shivamchudasama/KumikoFrame_3DPrinting/Print Profiles & STLs/README.md

The Files may NOT be shared, sold, or redistributed in any way. That includes STL Files, OpenScad (.scad) files, 3MF files, Links, or any file downloaded from this membership. 

Patreon Catalogue: https://docs.google.com/document/d/19o8Xd_KaTCOf8iYQQnmPdljipetqtiDV3wMY0SX3PGU/edit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

Source Code Instructions: https://docs.google.com/document/d/19o8Xd_KaTCOf8iYQQnmPdljipetqtiDV3wMY0SX3PGU/edit?tab=t.pa5v3ukzsqc0

Assembly Instructions: https://docs.google.com/document/d/19o8Xd_KaTCOf8iYQQnmPdljipetqtiDV3wMY0SX3PGU/edit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

License Details: https://docs.google.com/document/d/1-UtIYotxhSvtmS18F5mEnJnP0xTTbvH1-aNAVjrADTA/edit?usp=sharing
