shivamchudasama/KumikoFrame_3DPrinting/Shivling/Referance Layout.png

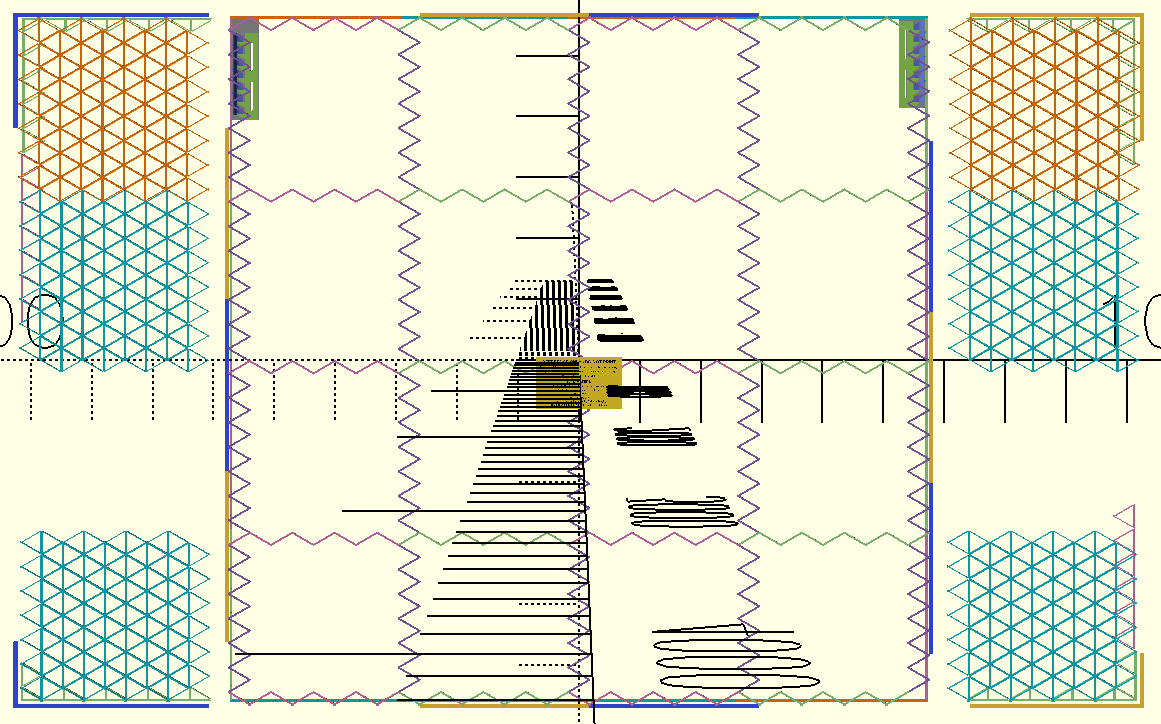
Shivling/Referance Layout.png
