shivamchudasama/KumikoFrame_3DPrinting/Shivling/Shivling_ModernArt_Shivam2_1_2.png

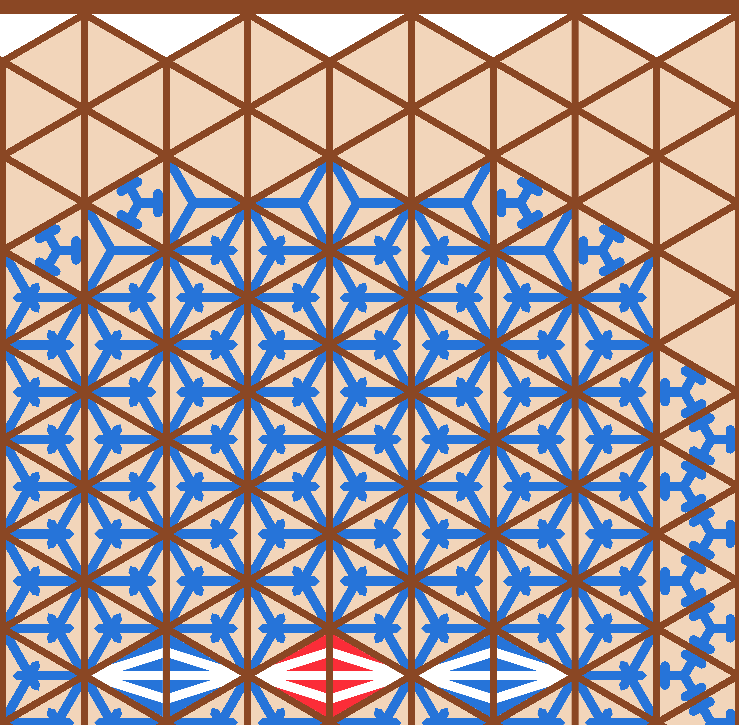
Shivling/Shivling_ModernArt_Shivam2_1_2.png
