shivamchudasama/KumikoFrame_3DPrinting/Shivling/Shivling_ModernArt_Shivam2_1_4.png

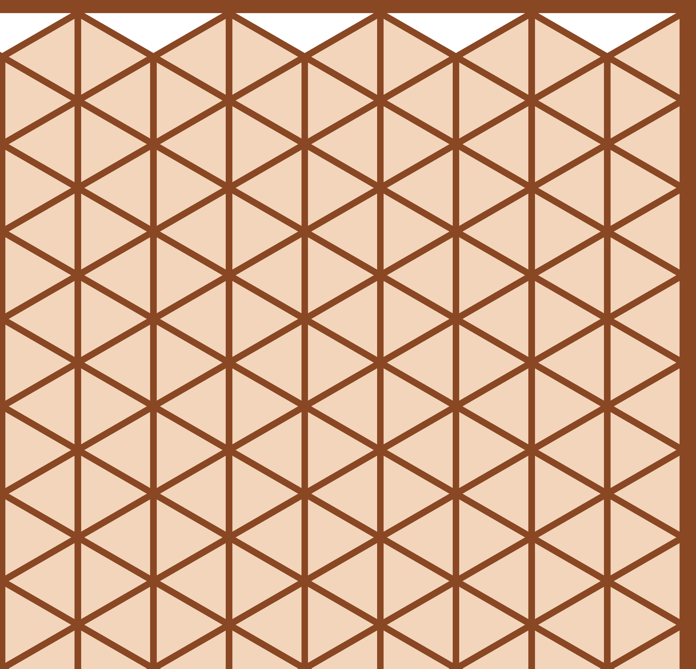
Shivling/Shivling_ModernArt_Shivam2_1_4.png
