shivamchudasama/KumikoFrame_3DPrinting/Shivling/Shivling_ModernArt_Shivam2_2_1.png

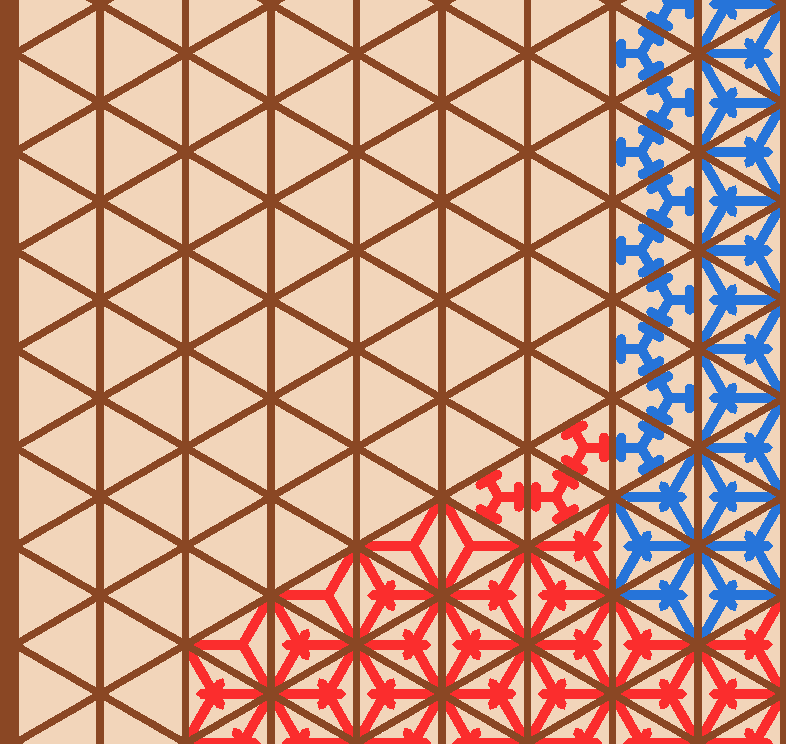
Shivling/Shivling_ModernArt_Shivam2_2_1.png
