shivamchudasama/KumikoFrame_3DPrinting/Shivling/Shivling_ModernArt_Shivam2_2_4.png

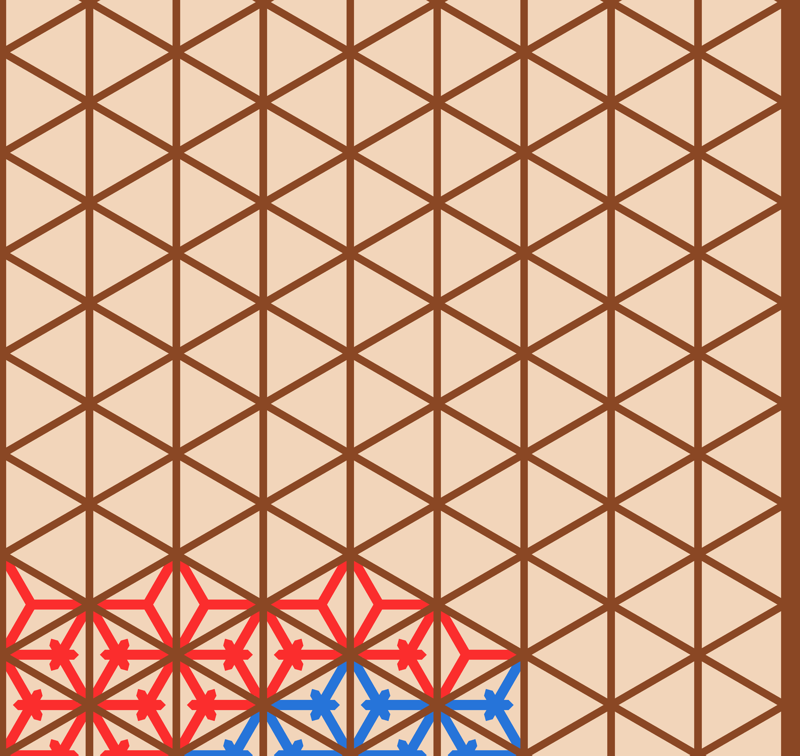
Shivling/Shivling_ModernArt_Shivam2_2_4.png
