shivamchudasama/KumikoFrame_3DPrinting/Shivling/Shivling_ModernArt_Shivam2_3_1.png

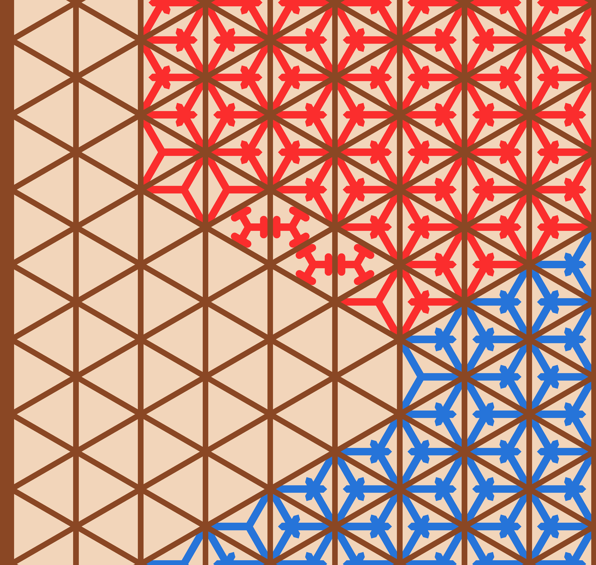
Shivling/Shivling_ModernArt_Shivam2_3_1.png
