shivamchudasama/KumikoFrame_3DPrinting/Shivling/Shivling_ModernArt_Shivam2_4_1.png

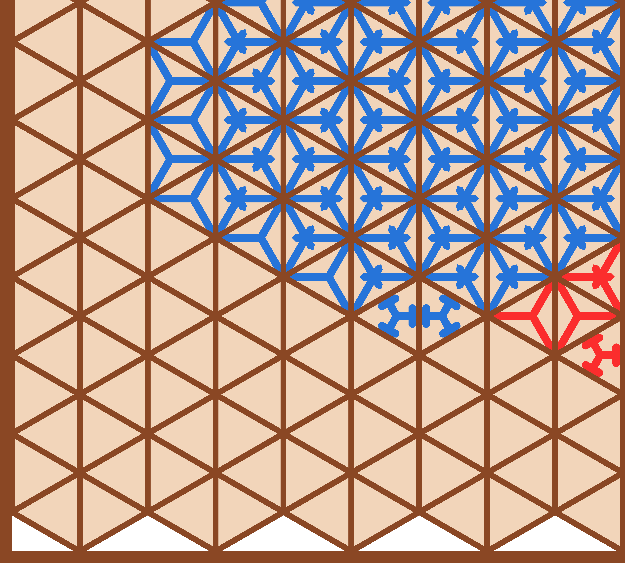
Shivling/Shivling_ModernArt_Shivam2_4_1.png
