shivamchudasama/KumikoFrame_3DPrinting/Print Profiles & STLs/V1 - Primary Panel/Frame Components.3mf

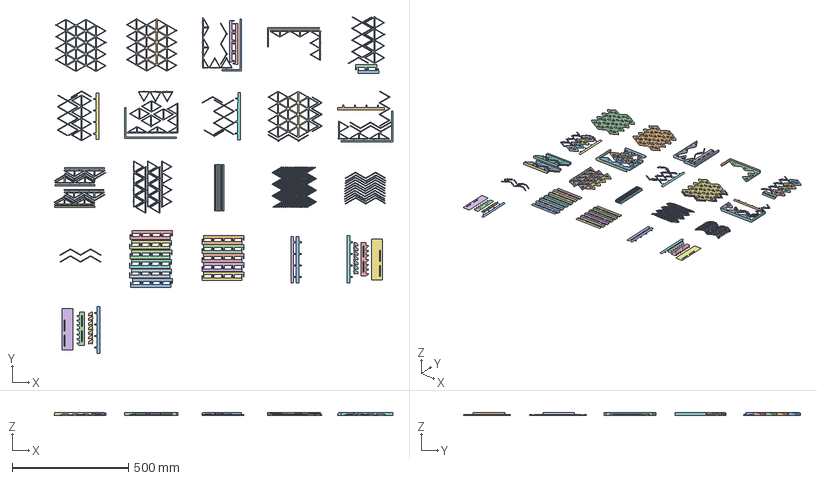
[picture p150: CAD file, 2026-07-01]
Print Profiles & STLs/V1 - Primary Panel/Frame Components.3mf
1458.2 x 1449.7 x 12.0 mm
Assembly x 11
even_hanger.stl_4
even_hanger.stl_5
even_hanger.stl_6
even_hanger.stl_7
