shivamchudasama/KumikoFrame_3DPrinting/Print Profiles & STLs/V1 - Secondary Panels/Frame Components.3mf

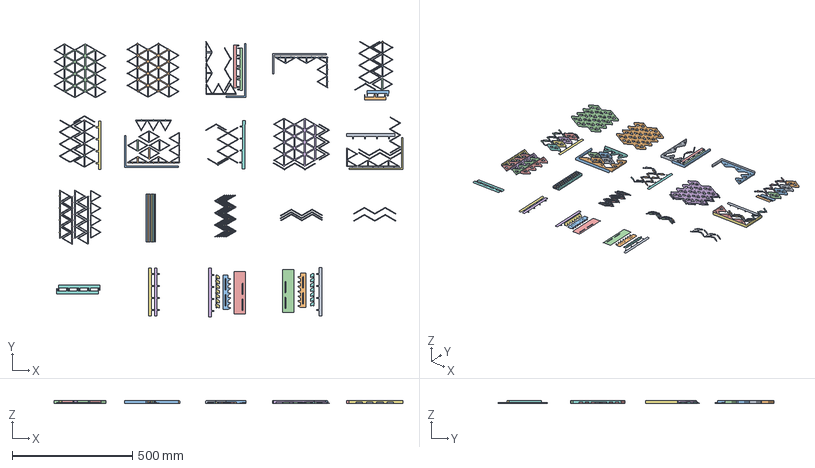
[picture p151: CAD file, 2026-07-01]
Print Profiles & STLs/V1 - Secondary Panels/Frame Components.3mf
1451.8 x 1147.7 x 12.0 mm
Assembly
even_hanger.stl_4
even_hanger.stl_5
even_hanger.stl_6
even_hanger.stl_7
