shivamchudasama/KumikoFrame_3DPrinting/Print Profiles & STLs/V2 - Fjallbo Compatible/Frame Components.3mf

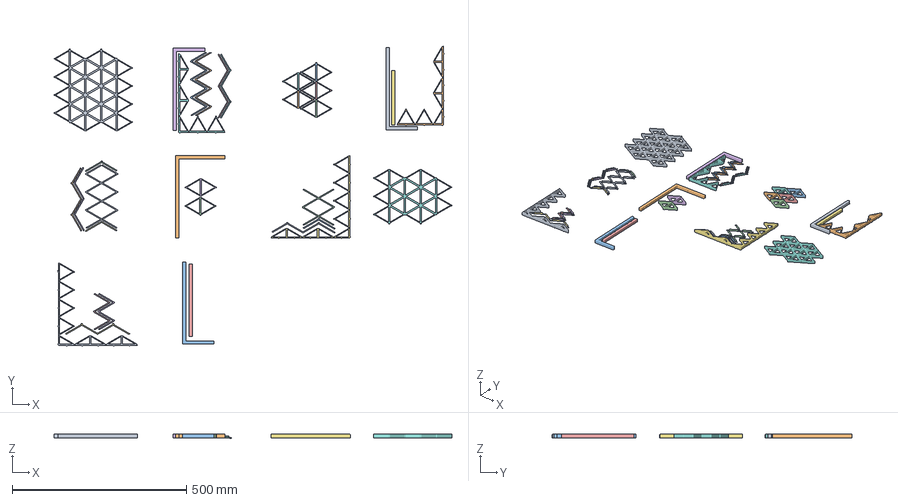
[picture p152: CAD file, 2026-07-01]
Print Profiles & STLs/V2 - Fjallbo Compatible/Frame Components.3mf
1142.2 x 860.6 x 12.0 mm
Frame Components.stl_2
Frame Components.stl_3
Frame Components.stl_13
Frame Components.stl_17
Frame Components.stl_10
Frame Components.stl_18
Frame Components.stl_4
Frame Components.stl_11
Frame Components.stl_5
Frame Components.stl_12
Frame Components.stl_6
Frame Components.stl_19
Frame Components.stl_8
Frame Components.stl_9
Frame Components.stl_15
Frame Components.stl_16
Frame Components.stl_20
Frame Components.stl_21
Frame Components.stl_22
Frame Components.stl_23
Frame Components.stl_24
Frame Components.stl_25
Frame Components.stl_26
Frame Components.stl_27
Frame Components.stl_28
Frame Components.stl_29
Frame Components.stl_30
Frame Components.stl_31
Frame Components.stl_32
Frame Components.stl_33
Frame Components.stl_34
Frame Components.stl_35
Frame Components.stl_36
Frame Components.stl_37
