shivamchudasama/KumikoFrame_3DPrinting/Print Profiles & STLs/V2 - Primary Panel & Alternatives/STLs/Magnet Holder.stl

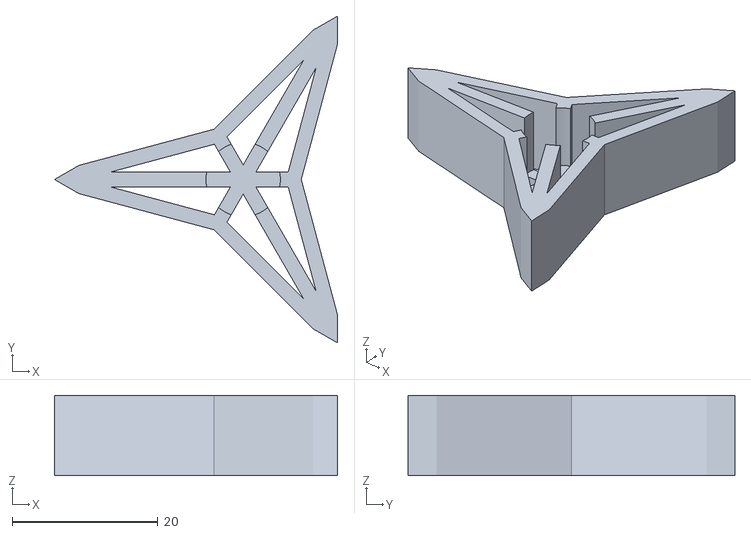
[picture p154: CAD file, 2026-07-01]
Print Profiles & STLs/V2 - Primary Panel & Alternatives/STLs/Magnet Holder.stl
38.8 x 44.8 x 11.0
