shivamchudasama/KumikoFrame_3DPrinting/Print Profiles & STLs/V2 - Primary Panel & Alternatives/Test Tube & Magnet Holder.3mf

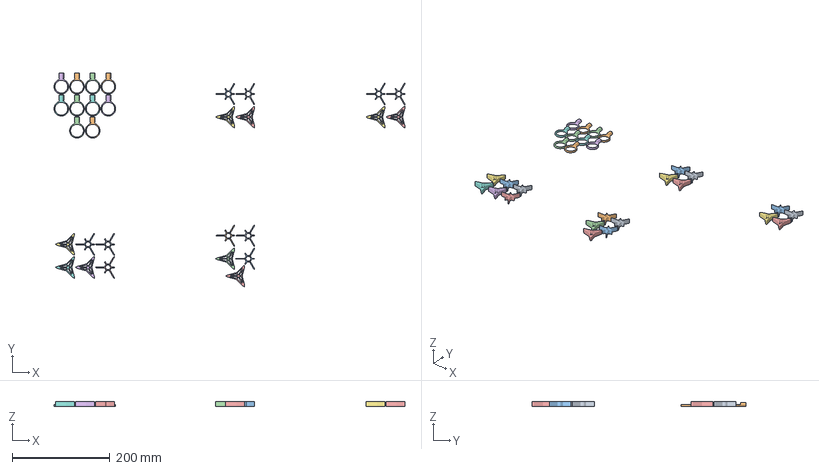
[picture p155: CAD file, 2026-07-01]
Print Profiles & STLs/V2 - Primary Panel & Alternatives/Test Tube & Magnet Holder.3mf
717.2 x 437.3 x 11.0 mm
Test Tube Holder.stl_1 x 10
Test Tube Holder.stl_2 x 10
Magnet Holder.stl x 9
