shivamchudasama/KumikoFrame_3DPrinting/Shivling/Boarder.3mf

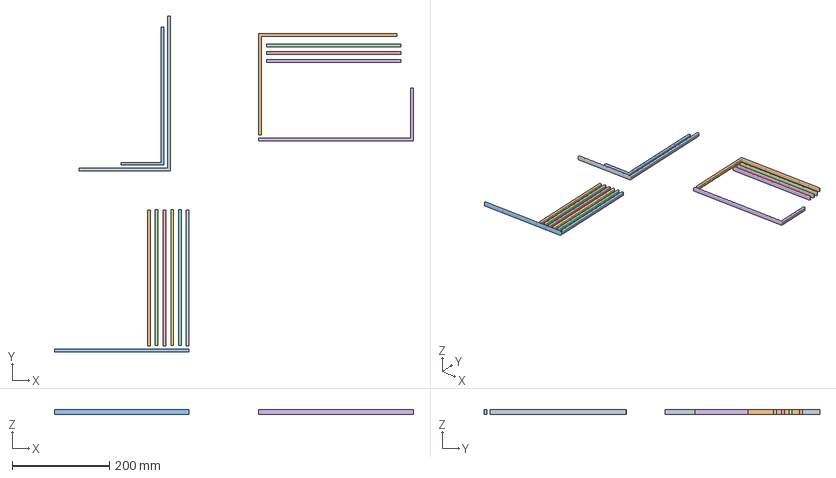
[picture p156: CAD file, 2026-07-20]
Shivling/Boarder.3mf
739.1 x 691.6 x 10.0 mm
Boarder.stl_1
Boarder.stl_11
Boarder.stl_6
Boarder.stl_2
Boarder.stl_4
Boarder.stl_5
Boarder.stl_12
Boarder.stl_14
Boarder.stl_3
Boarder.stl_13
Boarder.stl_7
Boarder.stl_8
Boarder.stl_9
Boarder.stl_10
