shivamchudasama/KumikoFrame_3DPrinting/Print Profiles & STLs/V1 - Primary Panel/Pattern Inserts.3mf

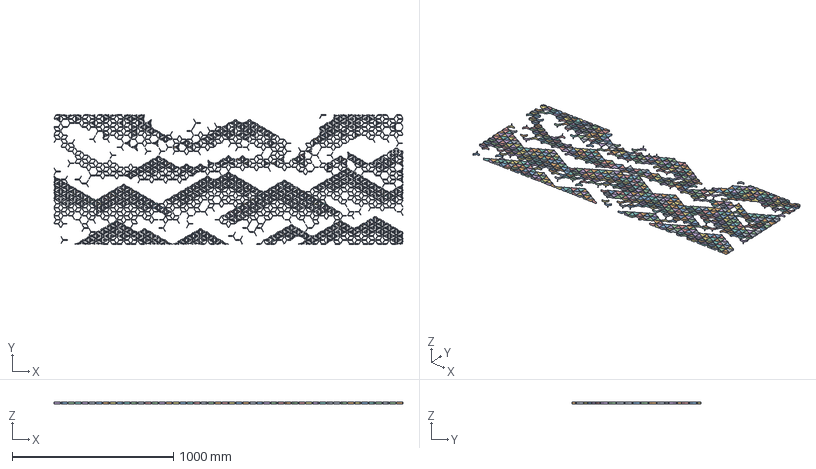
[picture p157: CAD file, 2026-07-01]
Print Profiles & STLs/V1 - Primary Panel/Pattern Inserts.3mf
2162.1 x 800.0 x 11.0 mm
Pattern Inserts.stl_283
Pattern Inserts.stl_284
Pattern Inserts.stl_299
Pattern Inserts.stl_300
Pattern Inserts.stl_311
Pattern Inserts.stl_312
Pattern Inserts.stl_313
Pattern Inserts.stl_324
Pattern Inserts.stl_333
Pattern Inserts.stl_334
Pattern Inserts.stl_352
Pattern Inserts.stl_353
Pattern Inserts.stl_354
Pattern Inserts.stl_373
Pattern Inserts.stl_374
Pattern Inserts.stl_375
Pattern Inserts.stl_393
Pattern Inserts.stl_409
Pattern Inserts.stl_422
Pattern Inserts.stl_435
Pattern Inserts.stl_445
Pattern Inserts.stl_446
Pattern Inserts.stl_458
Pattern Inserts.stl_459
Pattern Inserts.stl_460
Pattern Inserts.stl_467
Pattern Inserts.stl_468
Pattern Inserts.stl_469
Pattern Inserts.stl_476
Pattern Inserts.stl_481
Pattern Inserts.stl_482
Pattern Inserts.stl_491
Pattern Inserts.stl_492
Pattern Inserts.stl_493
Pattern Inserts.stl_503
Pattern Inserts.stl_504
Pattern Inserts.stl_505
Pattern Inserts.stl_523
Pattern Inserts.stl_524
Pattern Inserts.stl_525
Pattern Inserts.stl_539
Pattern Inserts.stl_548
Pattern Inserts.stl_549
Pattern Inserts.stl_565
Pattern Inserts.stl_566
Pattern Inserts.stl_567
Pattern Inserts.stl_589
Pattern Inserts.stl_590
Pattern Inserts.stl_591
Pattern Inserts.stl_610
Pattern Inserts.stl_611
Pattern Inserts.stl_612
Pattern Inserts.stl_638
Pattern Inserts.stl_639
Pattern Inserts.stl_1
Pattern Inserts.stl_2
Pattern Inserts.stl_3
Pattern Inserts.stl_4
Pattern Inserts.stl_5
Pattern Inserts.stl_6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
