shivamchudasama/KumikoFrame_3DPrinting/Print Profiles & STLs/V1 - Secondary Panels/Pattern Inserts - Symmetry.3mf

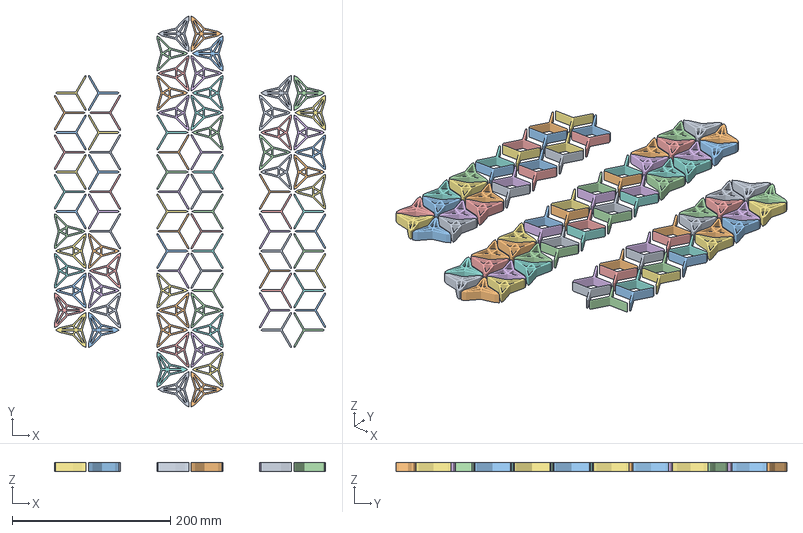
[picture p158: CAD file, 2026-07-01]
Print Profiles & STLs/V1 - Secondary Panels/Pattern Inserts - Symmetry.3mf
343.4 x 494.8 x 11.0 mm
Pattern Inserts - Symmetry.stl_1
Pattern Inserts - Symmetry.stl_2
Pattern Inserts - Symmetry.stl_3
Pattern Inserts - Symmetry.stl_4
Pattern Inserts - Symmetry.stl_5
Pattern Inserts - Symmetry.stl_6
Pattern Inserts - Symmetry.stl_7
Pattern Inserts - Symmetry.stl_8
Pattern Inserts - Symmetry.stl_9
Pattern Inserts - Symmetry.stl_10
Pattern Inserts - Symmetry.stl_11
Pattern Inserts - Symmetry.stl_12
Pattern Inserts - Symmetry.stl_13
Pattern Inserts - Symmetry.stl_14
Pattern Inserts - Symmetry.stl_15
Pattern Inserts - Symmetry.stl_16
Pattern Inserts - Symmetry.stl_17
Pattern Inserts - Symmetry.stl_18
Pattern Inserts - Symmetry.stl_19
Pattern Inserts - Symmetry.stl_20
Pattern Inserts - Symmetry.stl_21
Pattern Inserts - Symmetry.stl_22
Pattern Inserts - Symmetry.stl_23
Pattern Inserts - Symmetry.stl_24
Pattern Inserts - Symmetry.stl_25
Pattern Inserts - Symmetry.stl_26
Pattern Inserts - Symmetry.stl_27
Pattern Inserts - Symmetry.stl_28
Pattern Inserts - Symmetry.stl_29
Pattern Inserts - Symmetry.stl_30
Pattern Inserts - Symmetry.stl_31
Pattern Inserts - Symmetry.stl_32
Pattern Inserts - Symmetry.stl_33
Pattern Inserts - Symmetry.stl_34
Pattern Inserts - Symmetry.stl_35
Pattern Inserts - Symmetry.stl_36
Pattern Inserts - Symmetry.stl_37
Pattern Inserts - Symmetry.stl_38
Pattern Inserts - Symmetry.stl_39
Pattern Inserts - Symmetry.stl_40
Pattern Inserts - Symmetry.stl_41
Pattern Inserts - Symmetry.stl_42
Pattern Inserts - Symmetry.stl_43
Pattern Inserts - Symmetry.stl_44
Pattern Inserts - Symmetry.stl_45
Pattern Inserts - Symmetry.stl_46
Pattern Inserts - Symmetry.stl_47
Pattern Inserts - Symmetry.stl_48
Pattern Inserts - Symmetry.stl_49
Pattern Inserts - Symmetry.stl_50
Pattern Inserts - Symmetry.stl_51
Pattern Inserts - Symmetry.stl_52
Pattern Inserts - Symmetry.stl_53
Pattern Inserts - Symmetry.stl_54
Pattern Inserts - Symmetry.stl_55
Pattern Inserts - Symmetry.stl_56
Pattern Inserts - Symmetry.stl_57
Pattern Inserts - Symmetry.stl_58
Pattern Inserts - Symmetry.stl_59
Pattern Inserts - Symmetry.stl_60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
