shivamchudasama/KumikoFrame_3DPrinting/Print Profiles & STLs/V2 - Fjallbo Compatible/Pattern Inserts.3mf

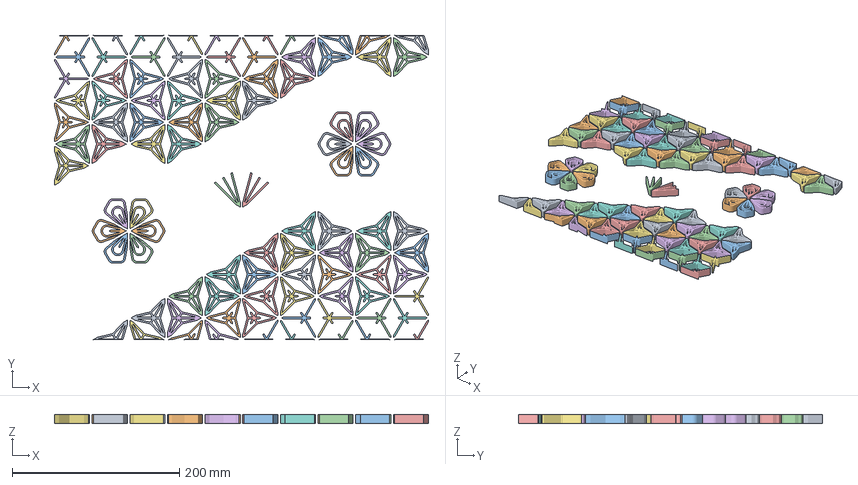
[picture p159: CAD file, 2026-07-01]
Print Profiles & STLs/V2 - Fjallbo Compatible/Pattern Inserts.3mf
447.3 x 364.0 x 11.0 mm
Pattern Inserts.stl_22
Pattern Inserts.stl_23
Pattern Inserts.stl_24
Pattern Inserts.stl_25
Pattern Inserts.stl_27
Pattern Inserts.stl_29
Pattern Inserts.stl_30
Pattern Inserts.stl_32
Pattern Inserts.stl_33
Pattern Inserts.stl_35
Pattern Inserts.stl_37
Pattern Inserts.stl_38
Pattern Inserts.stl_39
Pattern Inserts.stl_41
Pattern Inserts.stl_43
Pattern Inserts.stl_45
Pattern Inserts.stl_46
Pattern Inserts.stl_48
Pattern Inserts.stl_49
Pattern Inserts.stl_51
Pattern Inserts.stl_52
Pattern Inserts.stl_53
Pattern Inserts.stl_54
Pattern Inserts.stl_55
Pattern Inserts.stl_57
Pattern Inserts.stl_60
Pattern Inserts.stl_61
Pattern Inserts.stl_62
Pattern Inserts.stl_63
Pattern Inserts.stl_64
Pattern Inserts.stl_66
Pattern Inserts.stl_68
Pattern Inserts.stl_69
Pattern Inserts.stl_71
Pattern Inserts.stl_73
Pattern Inserts.stl_74
Pattern Inserts.stl_75
Pattern Inserts.stl_76
Pattern Inserts.stl_78
Pattern Inserts.stl_80
Pattern Inserts.stl_1
Pattern Inserts.stl_2
Pattern Inserts.stl_3
Pattern Inserts.stl_4
Pattern Inserts.stl_5
Pattern Inserts.stl_6
Pattern Inserts.stl_7
Pattern Inserts.stl_8
Pattern Inserts.stl_9
Pattern Inserts.stl_10
Pattern Inserts.stl_11
Pattern Inserts.stl_12
Pattern Inserts.stl_13
Pattern Inserts.stl_14
Pattern Inserts.stl_15
Pattern Inserts.stl_16
Pattern Inserts.stl_17
Pattern Inserts.stl_18
Pattern Inserts.stl_19
Pattern Inserts.stl_20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
