shivamchudasama/KumikoFrame_3DPrinting/Print Profiles & STLs/V2 - Gorilla Shelf Compatible/Keyhole Hanger.3mf

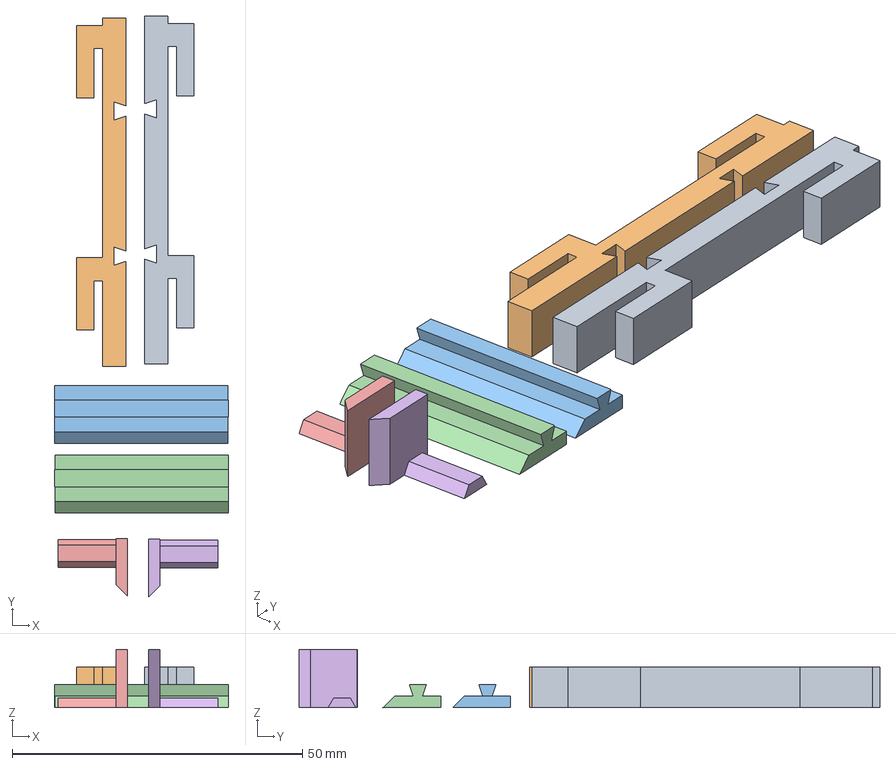
[picture p160: CAD file, 2026-07-01]
Print Profiles & STLs/V2 - Gorilla Shelf Compatible/Keyhole Hanger.3mf
30.0 x 100.1 x 10.0 mm
