shivamchudasama/KumikoFrame_3DPrinting/Print Profiles & STLs/V2 - Primary Panel & Alternatives/Frame Components.3mf

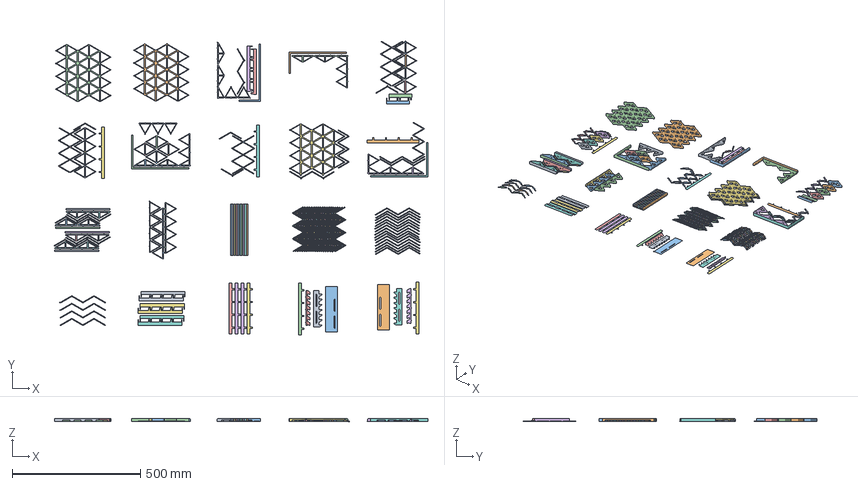
[picture p161: CAD file, 2026-07-01]
Print Profiles & STLs/V2 - Primary Panel & Alternatives/Frame Components.3mf
1459.4 x 1148.0 x 12.0 mm
Assembly x 3
even_hanger.stl_4
even_hanger.stl_5
even_hanger.stl_6
even_hanger.stl_7
