shivamchudasama/KumikoFrame_3DPrinting/Print Profiles & STLs/V2 - Primary Panel & Alternatives/STLs/Test Tube Holder.stl

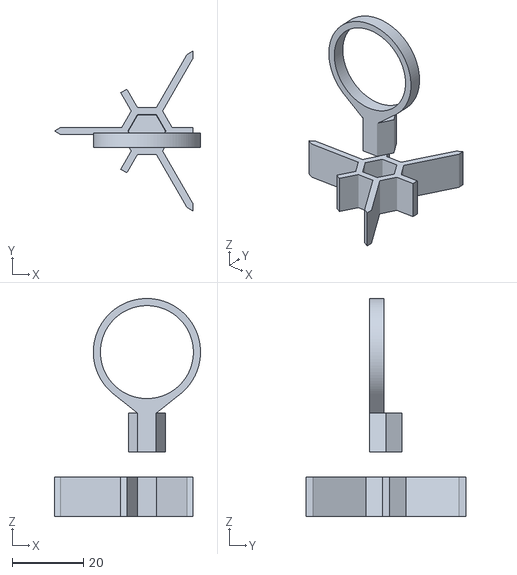
[picture p162: CAD file, 2026-07-01]
Print Profiles & STLs/V2 - Primary Panel & Alternatives/STLs/Test Tube Holder.stl
40.9 x 44.8 x 61.0
