shivamchudasama/KumikoFrame_3DPrinting/Shivling/Insert_39_4mm.stl

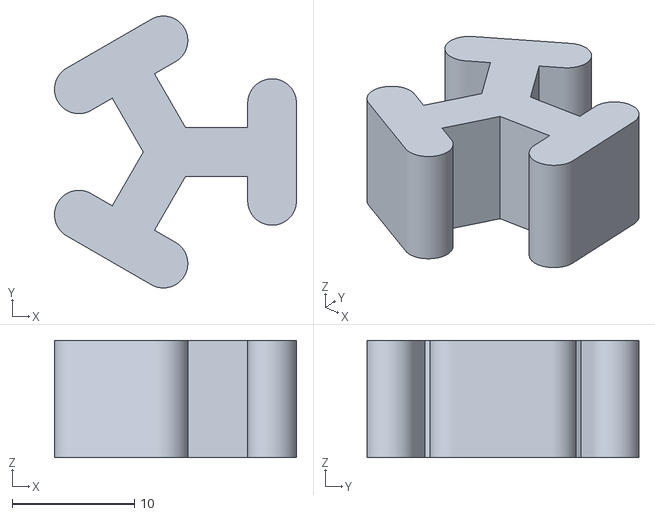
[picture p163: CAD file, 2026-07-20]
Shivling/Insert_39_4mm.stl
19.8 x 22.3 x 9.60
