shivamchudasama/KumikoFrame_3DPrinting/Print Profiles & STLs/V1 - Primary Panel/Background Inserts.3mf

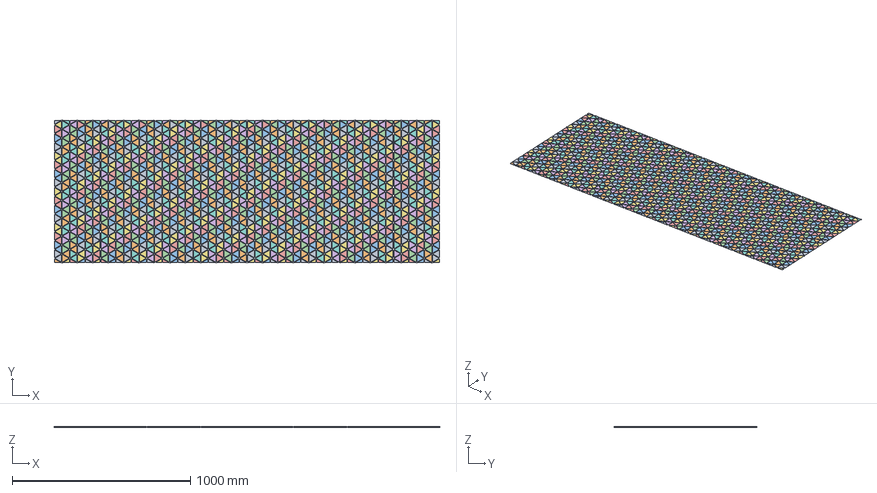
[picture p164: CAD file, 2026-07-01]
Print Profiles & STLs/V1 - Primary Panel/Background Inserts.3mf
2162.1 x 800.0 x 0.6 mm
Background Inserts.stl_1
Background Inserts.stl_2
Background Inserts.stl_3
Background Inserts.stl_4
Background Inserts.stl_5
Background Inserts.stl_6
Background Inserts.stl_7
Background Inserts.stl_8
Background Inserts.stl_9
Background Inserts.stl_10
Background Inserts.stl_11
Background Inserts.stl_12
Background Inserts.stl_13
Background Inserts.stl_14
Background Inserts.stl_15
Background Inserts.stl_16
Background Inserts.stl_17
Background Inserts.stl_18
Background Inserts.stl_19
Background Inserts.stl_20
Background Inserts.stl_21
Background Inserts.stl_22
Background Inserts.stl_23
Background Inserts.stl_24
Background Inserts.stl_25
Background Inserts.stl_26
Background Inserts.stl_27
Background Inserts.stl_28
Background Inserts.stl_29
Background Inserts.stl_30
Background Inserts.stl_31
Background Inserts.stl_32
Background Inserts.stl_33
Background Inserts.stl_34
Background Inserts.stl_35
Background Inserts.stl_36
Background Inserts.stl_37
Background Inserts.stl_38
Background Inserts.stl_39
Background Inserts.stl_40
Background Inserts.stl_41
Background Inserts.stl_42
Background Inserts.stl_43
Background Inserts.stl_44
Background Inserts.stl_45
Background Inserts.stl_46
Background Inserts.stl_47
Background Inserts.stl_48
Background Inserts.stl_49
Background Inserts.stl_50
Background Inserts.stl_51
Background Inserts.stl_52
Background Inserts.stl_53
Background Inserts.stl_54
Background Inserts.stl_55
Background Inserts.stl_56
Background Inserts.stl_57
Background Inserts.stl_58
Background Inserts.stl_59
Background Inserts.stl_60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
