shivamchudasama/KumikoFrame_3DPrinting/Print Profiles & STLs/V2 - Fjallbo Compatible/Background Inserts__Optional.3mf

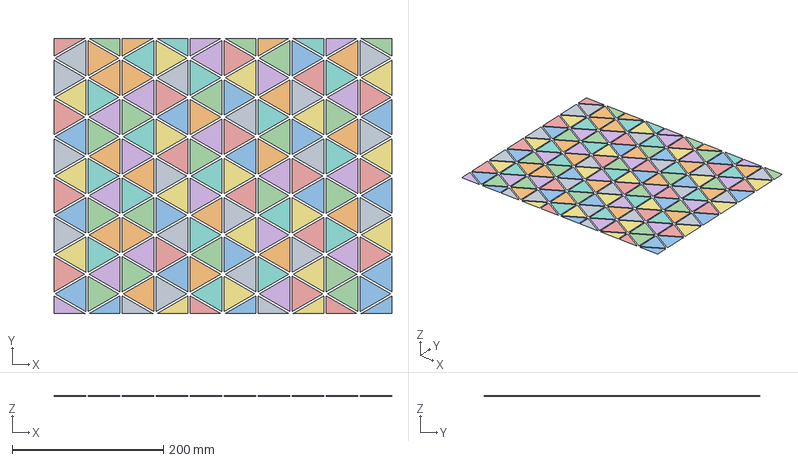
[picture p166: CAD file, 2026-07-01]
Print Profiles & STLs/V2 - Fjallbo Compatible/Background Inserts__Optional.3mf
447.3 x 364.0 x 0.6 mm
Background Inserts__Optional.stl_13
Background Inserts__Optional.stl_14
Background Inserts__Optional.stl_15
Background Inserts__Optional.stl_16
Background Inserts__Optional.stl_17
Background Inserts__Optional.stl_18
Background Inserts__Optional.stl_23
Background Inserts__Optional.stl_24
Background Inserts__Optional.stl_25
Background Inserts__Optional.stl_26
Background Inserts__Optional.stl_27
Background Inserts__Optional.stl_28
Background Inserts__Optional.stl_33
Background Inserts__Optional.stl_34
Background Inserts__Optional.stl_35
Background Inserts__Optional.stl_36
Background Inserts__Optional.stl_37
Background Inserts__Optional.stl_38
Background Inserts__Optional.stl_43
Background Inserts__Optional.stl_44
Background Inserts__Optional.stl_45
Background Inserts__Optional.stl_46
Background Inserts__Optional.stl_47
Background Inserts__Optional.stl_48
Background Inserts__Optional.stl_53
Background Inserts__Optional.stl_54
Background Inserts__Optional.stl_55
Background Inserts__Optional.stl_56
Background Inserts__Optional.stl_57
Background Inserts__Optional.stl_58
Background Inserts__Optional.stl_73
Background Inserts__Optional.stl_74
Background Inserts__Optional.stl_75
Background Inserts__Optional.stl_76
Background Inserts__Optional.stl_77
Background Inserts__Optional.stl_78
Background Inserts__Optional.stl_83
Background Inserts__Optional.stl_84
Background Inserts__Optional.stl_85
Background Inserts__Optional.stl_86
Background Inserts__Optional.stl_87
Background Inserts__Optional.stl_88
Background Inserts__Optional.stl_93
Background Inserts__Optional.stl_94
Background Inserts__Optional.stl_95
Background Inserts__Optional.stl_96
Background Inserts__Optional.stl_97
Background Inserts__Optional.stl_98
Background Inserts__Optional.stl_103
Background Inserts__Optional.stl_104
Background Inserts__Optional.stl_105
Background Inserts__Optional.stl_106
Background Inserts__Optional.stl_107
Background Inserts__Optional.stl_108
Background Inserts__Optional.stl_113
Background Inserts__Optional.stl_114
Background Inserts__Optional.stl_115
Background Inserts__Optional.stl_116
Background Inserts__Optional.stl_117
Background Inserts__Optional.stl_118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
