shivamchudasama/KumikoFrame_3DPrinting/Print Profiles & STLs/V2 - Gorilla Shelf Compatible/Frame Components.3mf

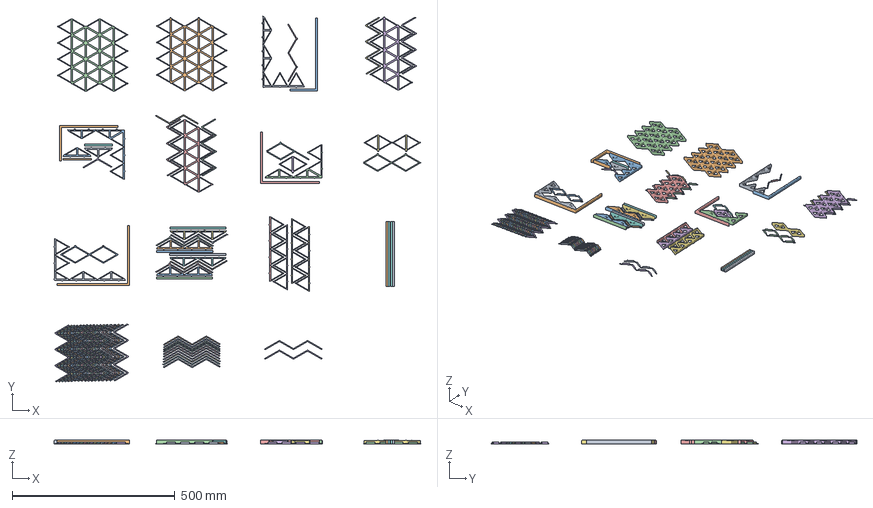
[picture p167: CAD file, 2026-07-01]
Print Profiles & STLs/V2 - Gorilla Shelf Compatible/Frame Components.3mf
1128.0 x 1125.9 x 12.0 mm
