shivamchudasama/KumikoFrame_3DPrinting/Print Profiles & STLs/V2 - Primary Panel & Alternatives/Pattern Inserts Intertwining.3mf

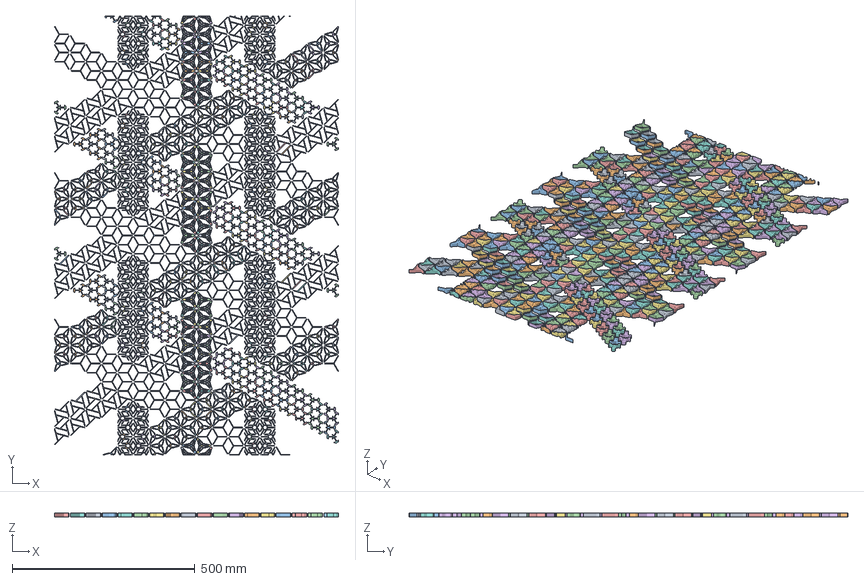
[picture p168: CAD file, 2026-07-01]
Print Profiles & STLs/V2 - Primary Panel & Alternatives/Pattern Inserts Intertwining.3mf
776.4 x 1200.0 x 11.0 mm
Pattern Inserts Intertwining.stl_1
Pattern Inserts Intertwining.stl_2
Pattern Inserts Intertwining.stl_3
Pattern Inserts Intertwining.stl_4
Pattern Inserts Intertwining.stl_5
Pattern Inserts Intertwining.stl_6
Pattern Inserts Intertwining.stl_7
Pattern Inserts Intertwining.stl_8
Pattern Inserts Intertwining.stl_9
Pattern Inserts Intertwining.stl_10
Pattern Inserts Intertwining.stl_11
Pattern Inserts Intertwining.stl_12
Pattern Inserts Intertwining.stl_13
Pattern Inserts Intertwining.stl_14
Pattern Inserts Intertwining.stl_15
Pattern Inserts Intertwining.stl_16
Pattern Inserts Intertwining.stl_17
Pattern Inserts Intertwining.stl_18
Pattern Inserts Intertwining.stl_19
Pattern Inserts Intertwining.stl_20
Pattern Inserts Intertwining.stl_21
Pattern Inserts Intertwining.stl_22
Pattern Inserts Intertwining.stl_23
Pattern Inserts Intertwining.stl_24
Pattern Inserts Intertwining.stl_25
Pattern Inserts Intertwining.stl_26
Pattern Inserts Intertwining.stl_27
Pattern Inserts Intertwining.stl_28
Pattern Inserts Intertwining.stl_29
Pattern Inserts Intertwining.stl_30
Pattern Inserts Intertwining.stl_31
Pattern Inserts Intertwining.stl_32
Pattern Inserts Intertwining.stl_33
Pattern Inserts Intertwining.stl_34
Pattern Inserts Intertwining.stl_35
Pattern Inserts Intertwining.stl_36
Pattern Inserts Intertwining.stl_37
Pattern Inserts Intertwining.stl_38
Pattern Inserts Intertwining.stl_39
Pattern Inserts Intertwining.stl_40
Pattern Inserts Intertwining.stl_41
Pattern Inserts Intertwining.stl_42
Pattern Inserts Intertwining.stl_43
Pattern Inserts Intertwining.stl_44
Pattern Inserts Intertwining.stl_45
Pattern Inserts Intertwining.stl_46
Pattern Inserts Intertwining.stl_47
Pattern Inserts Intertwining.stl_48
Pattern Inserts Intertwining.stl_49
Pattern Inserts Intertwining.stl_50
Pattern Inserts Intertwining.stl_51
Pattern Inserts Intertwining.stl_52
Pattern Inserts Intertwining.stl_53
Pattern Inserts Intertwining.stl_54
Pattern Inserts Intertwining.stl_55
Pattern Inserts Intertwining.stl_56
Pattern Inserts Intertwining.stl_57
Pattern Inserts Intertwining.stl_58
Pattern Inserts Intertwining.stl_59
Pattern Inserts Intertwining.stl_60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
