shivamchudasama/KumikoFrame_3DPrinting/Shivling/Boarder Background 2 Hangers.stl

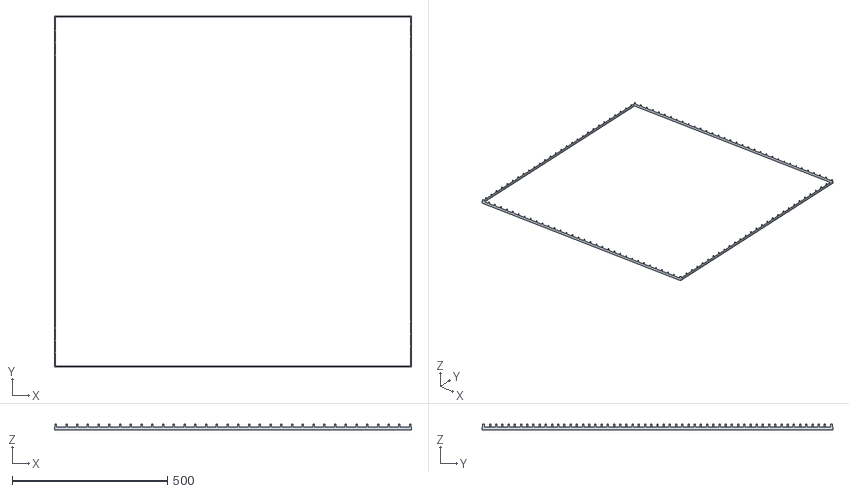
[picture p169: CAD file, 2026-07-20]
Shivling/Boarder Background 2 Hangers.stl
1152.2 x 1132.0 x 18.5
