shivamchudasama/KumikoFrame_3DPrinting/Print Profiles & STLs/V1 - Secondary Panels/Pattern Inserts - Mountains.3mf

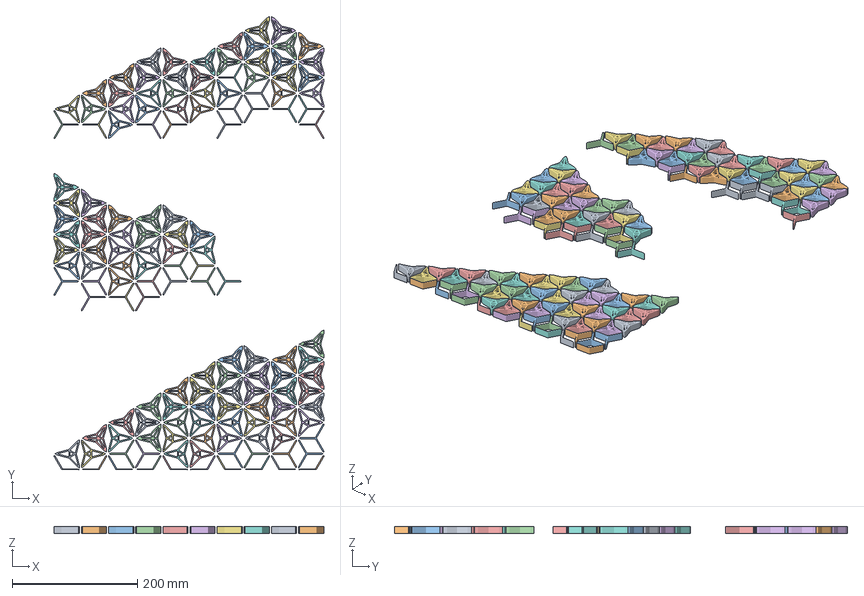
[picture p170: CAD file, 2026-07-01]
Print Profiles & STLs/V1 - Secondary Panels/Pattern Inserts - Mountains.3mf
430.0 x 722.4 x 11.0 mm
Pattern Inserts - Mountains.stl_1
Pattern Inserts - Mountains.stl_2
Pattern Inserts - Mountains.stl_3
Pattern Inserts - Mountains.stl_4
Pattern Inserts - Mountains.stl_5
Pattern Inserts - Mountains.stl_6
Pattern Inserts - Mountains.stl_7
Pattern Inserts - Mountains.stl_8
Pattern Inserts - Mountains.stl_9
Pattern Inserts - Mountains.stl_10
Pattern Inserts - Mountains.stl_11
Pattern Inserts - Mountains.stl_12
Pattern Inserts - Mountains.stl_13
Pattern Inserts - Mountains.stl_14
Pattern Inserts - Mountains.stl_15
Pattern Inserts - Mountains.stl_16
Pattern Inserts - Mountains.stl_17
Pattern Inserts - Mountains.stl_18
Pattern Inserts - Mountains.stl_19
Pattern Inserts - Mountains.stl_20
Pattern Inserts - Mountains.stl_21
Pattern Inserts - Mountains.stl_22
Pattern Inserts - Mountains.stl_23
Pattern Inserts - Mountains.stl_24
Pattern Inserts - Mountains.stl_25
Pattern Inserts - Mountains.stl_26
Pattern Inserts - Mountains.stl_27
Pattern Inserts - Mountains.stl_28
Pattern Inserts - Mountains.stl_29
Pattern Inserts - Mountains.stl_30
Pattern Inserts - Mountains.stl_31
Pattern Inserts - Mountains.stl_32
Pattern Inserts - Mountains.stl_33
Pattern Inserts - Mountains.stl_34
Pattern Inserts - Mountains.stl_35
Pattern Inserts - Mountains.stl_36
Pattern Inserts - Mountains.stl_37
Pattern Inserts - Mountains.stl_38
Pattern Inserts - Mountains.stl_39
Pattern Inserts - Mountains.stl_40
Pattern Inserts - Mountains.stl_41
Pattern Inserts - Mountains.stl_42
Pattern Inserts - Mountains.stl_43
Pattern Inserts - Mountains.stl_44
Pattern Inserts - Mountains.stl_45
Pattern Inserts - Mountains.stl_46
Pattern Inserts - Mountains.stl_47
Pattern Inserts - Mountains.stl_48
Pattern Inserts - Mountains.stl_49
Pattern Inserts - Mountains.stl_50
Pattern Inserts - Mountains.stl_51
Pattern Inserts - Mountains.stl_52
Pattern Inserts - Mountains.stl_53
Pattern Inserts - Mountains.stl_54
Pattern Inserts - Mountains.stl_55
Pattern Inserts - Mountains.stl_56
Pattern Inserts - Mountains.stl_57
Pattern Inserts - Mountains.stl_58
Pattern Inserts - Mountains.stl_59
Pattern Inserts - Mountains.stl_60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
