shivamchudasama/KumikoFrame_3DPrinting/Print Profiles & STLs/V2 - Fjallbo Compatible/Fjallbo Compatible Hanger.3mf

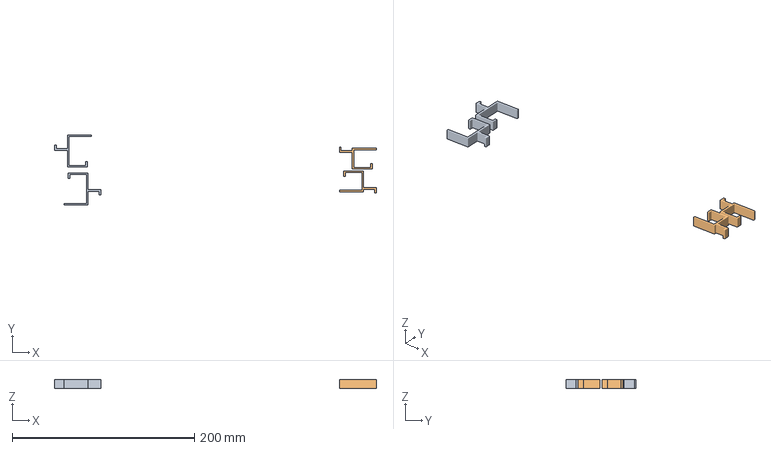
[picture p171: CAD file, 2026-07-01]
Print Profiles & STLs/V2 - Fjallbo Compatible/Fjallbo Compatible Hanger.3mf
353.0 x 77.1 x 10.0 mm
Assembly x 2
