shivamchudasama/KumikoFrame_3DPrinting/Print Profiles & STLs/V2 - Gorilla Shelf Compatible/Background Components.3mf

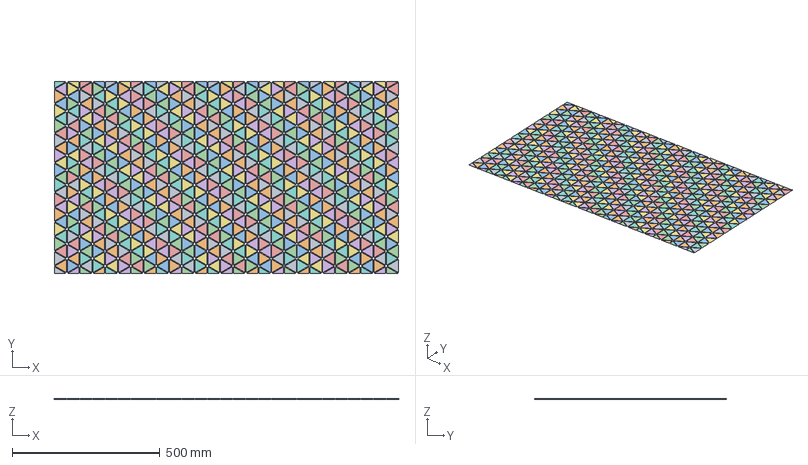
[picture p172: CAD file, 2026-07-01]
Print Profiles & STLs/V2 - Gorilla Shelf Compatible/Background Components.3mf
1166.1 x 650.0 x 0.6 mm
Background Components.stl_1
Background Components.stl_2
Background Components.stl_3
Background Components.stl_4
Background Components.stl_5
Background Components.stl_6
Background Components.stl_7
Background Components.stl_8
Background Components.stl_9
Background Components.stl_10
Background Components.stl_11
Background Components.stl_12
Background Components.stl_13
Background Components.stl_14
Background Components.stl_15
Background Components.stl_16
Background Components.stl_17
Background Components.stl_18
Background Components.stl_19
Background Components.stl_20
Background Components.stl_21
Background Components.stl_22
Background Components.stl_23
Background Components.stl_24
Background Components.stl_25
Background Components.stl_26
Background Components.stl_27
Background Components.stl_28
Background Components.stl_29
Background Components.stl_30
Background Components.stl_31
Background Components.stl_32
Background Components.stl_33
Background Components.stl_34
Background Components.stl_35
Background Components.stl_36
Background Components.stl_37
Background Components.stl_38
Background Components.stl_39
Background Components.stl_40
Background Components.stl_41
Background Components.stl_42
Background Components.stl_43
Background Components.stl_44
Background Components.stl_45
Background Components.stl_46
Background Components.stl_47
Background Components.stl_48
Background Components.stl_49
Background Components.stl_50
Background Components.stl_51
Background Components.stl_52
Background Components.stl_53
Background Components.stl_54
Background Components.stl_55
Background Components.stl_56
Background Components.stl_57
Background Components.stl_58
Background Components.stl_59
Background Components.stl_60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
