shivamchudasama/KumikoFrame_3DPrinting/Print Profiles & STLs/V2 - Primary Panel & Alternatives/Pattern Inserts Cubes.3mf

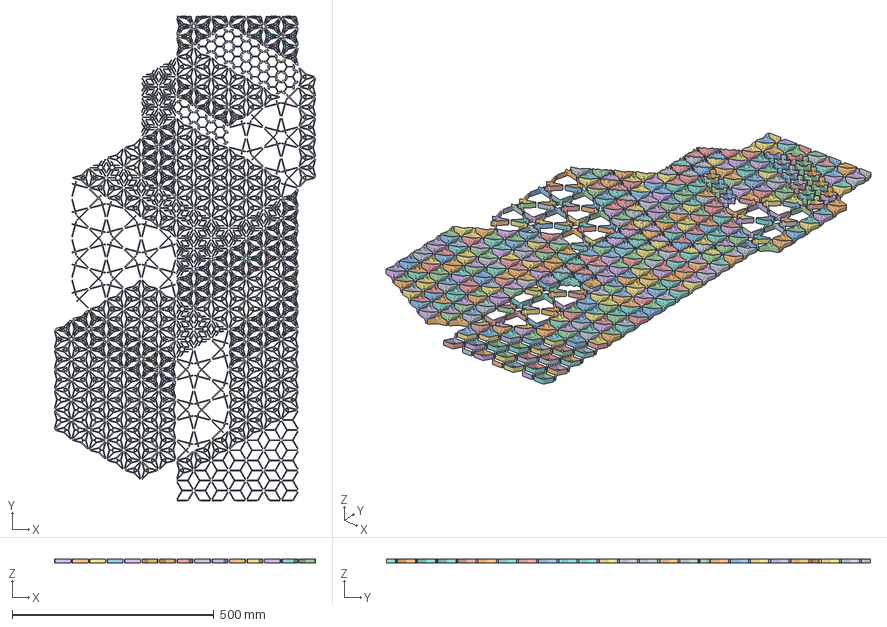
[picture p173: CAD file, 2026-07-01]
Print Profiles & STLs/V2 - Primary Panel & Alternatives/Pattern Inserts Cubes.3mf
646.5 x 1200.0 x 11.0 mm
Pattern Inserts Cubes.stl_1
Pattern Inserts Cubes.stl_2
Pattern Inserts Cubes.stl_3
Pattern Inserts Cubes.stl_4
Pattern Inserts Cubes.stl_5
Pattern Inserts Cubes.stl_6
Pattern Inserts Cubes.stl_7
Pattern Inserts Cubes.stl_8
Pattern Inserts Cubes.stl_9
Pattern Inserts Cubes.stl_10
Pattern Inserts Cubes.stl_11
Pattern Inserts Cubes.stl_12
Pattern Inserts Cubes.stl_13
Pattern Inserts Cubes.stl_14
Pattern Inserts Cubes.stl_15
Pattern Inserts Cubes.stl_16
Pattern Inserts Cubes.stl_17
Pattern Inserts Cubes.stl_18
Pattern Inserts Cubes.stl_19
Pattern Inserts Cubes.stl_20
Pattern Inserts Cubes.stl_21
Pattern Inserts Cubes.stl_22
Pattern Inserts Cubes.stl_23
Pattern Inserts Cubes.stl_24
Pattern Inserts Cubes.stl_25
Pattern Inserts Cubes.stl_26
Pattern Inserts Cubes.stl_27
Pattern Inserts Cubes.stl_28
Pattern Inserts Cubes.stl_29
Pattern Inserts Cubes.stl_30
Pattern Inserts Cubes.stl_31
Pattern Inserts Cubes.stl_32
Pattern Inserts Cubes.stl_33
Pattern Inserts Cubes.stl_34
Pattern Inserts Cubes.stl_35
Pattern Inserts Cubes.stl_36
Pattern Inserts Cubes.stl_37
Pattern Inserts Cubes.stl_38
Pattern Inserts Cubes.stl_39
Pattern Inserts Cubes.stl_40
Pattern Inserts Cubes.stl_41
Pattern Inserts Cubes.stl_42
Pattern Inserts Cubes.stl_43
Pattern Inserts Cubes.stl_44
Pattern Inserts Cubes.stl_45
Pattern Inserts Cubes.stl_46
Pattern Inserts Cubes.stl_47
Pattern Inserts Cubes.stl_48
Pattern Inserts Cubes.stl_49
Pattern Inserts Cubes.stl_50
Pattern Inserts Cubes.stl_51
Pattern Inserts Cubes.stl_52
Pattern Inserts Cubes.stl_53
Pattern Inserts Cubes.stl_54
Pattern Inserts Cubes.stl_55
Pattern Inserts Cubes.stl_56
Pattern Inserts Cubes.stl_57
Pattern Inserts Cubes.stl_58
Pattern Inserts Cubes.stl_59
Pattern Inserts Cubes.stl_60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
