shivamchudasama/KumikoFrame_3DPrinting/Shivling/Hanger 2 Hangers.stl

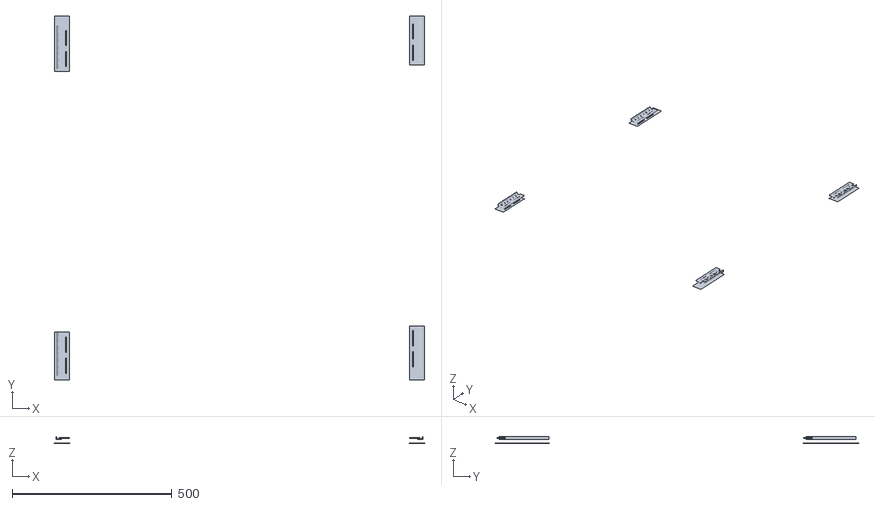
[picture p174: CAD file, 2026-07-20]
Shivling/Hanger 2 Hangers.stl
1158.2 x 1138.0 x 21.7
