shivamchudasama/KumikoFrame_3DPrinting/Print Profiles & STLs/V1 - Secondary Panels/Pattern Inserts - Large Hexagon.3mf

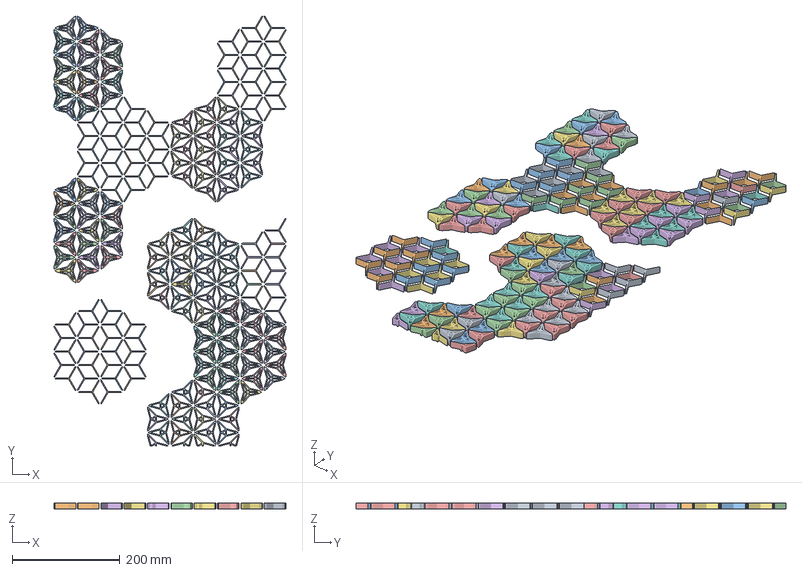
[picture p175: CAD file, 2026-07-01]
Print Profiles & STLs/V1 - Secondary Panels/Pattern Inserts - Large Hexagon.3mf
430.0 x 797.4 x 11.0 mm
Pattern Inserts - Large Hexagon.stl_1
Pattern Inserts - Large Hexagon.stl_2
Pattern Inserts - Large Hexagon.stl_3
Pattern Inserts - Large Hexagon.stl_4
Pattern Inserts - Large Hexagon.stl_5
Pattern Inserts - Large Hexagon.stl_6
Pattern Inserts - Large Hexagon.stl_7
Pattern Inserts - Large Hexagon.stl_8
Pattern Inserts - Large Hexagon.stl_9
Pattern Inserts - Large Hexagon.stl_10
Pattern Inserts - Large Hexagon.stl_11
Pattern Inserts - Large Hexagon.stl_12
Pattern Inserts - Large Hexagon.stl_13
Pattern Inserts - Large Hexagon.stl_14
Pattern Inserts - Large Hexagon.stl_15
Pattern Inserts - Large Hexagon.stl_16
Pattern Inserts - Large Hexagon.stl_17
Pattern Inserts - Large Hexagon.stl_18
Pattern Inserts - Large Hexagon.stl_19
Pattern Inserts - Large Hexagon.stl_20
Pattern Inserts - Large Hexagon.stl_21
Pattern Inserts - Large Hexagon.stl_22
Pattern Inserts - Large Hexagon.stl_23
Pattern Inserts - Large Hexagon.stl_24
Pattern Inserts - Large Hexagon.stl_25
Pattern Inserts - Large Hexagon.stl_26
Pattern Inserts - Large Hexagon.stl_27
Pattern Inserts - Large Hexagon.stl_28
Pattern Inserts - Large Hexagon.stl_29
Pattern Inserts - Large Hexagon.stl_30
Pattern Inserts - Large Hexagon.stl_31
Pattern Inserts - Large Hexagon.stl_32
Pattern Inserts - Large Hexagon.stl_33
Pattern Inserts - Large Hexagon.stl_34
Pattern Inserts - Large Hexagon.stl_35
Pattern Inserts - Large Hexagon.stl_36
Pattern Inserts - Large Hexagon.stl_37
Pattern Inserts - Large Hexagon.stl_38
Pattern Inserts - Large Hexagon.stl_39
Pattern Inserts - Large Hexagon.stl_40
Pattern Inserts - Large Hexagon.stl_41
Pattern Inserts - Large Hexagon.stl_42
Pattern Inserts - Large Hexagon.stl_43
Pattern Inserts - Large Hexagon.stl_44
Pattern Inserts - Large Hexagon.stl_45
Pattern Inserts - Large Hexagon.stl_46
Pattern Inserts - Large Hexagon.stl_47
Pattern Inserts - Large Hexagon.stl_48
Pattern Inserts - Large Hexagon.stl_49
Pattern Inserts - Large Hexagon.stl_50
Pattern Inserts - Large Hexagon.stl_51
Pattern Inserts - Large Hexagon.stl_52
Pattern Inserts - Large Hexagon.stl_53
Pattern Inserts - Large Hexagon.stl_54
Pattern Inserts - Large Hexagon.stl_55
Pattern Inserts - Large Hexagon.stl_56
Pattern Inserts - Large Hexagon.stl_57
Pattern Inserts - Large Hexagon.stl_58
Pattern Inserts - Large Hexagon.stl_59
Pattern Inserts - Large Hexagon.stl_60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
