shivamchudasama/KumikoFrame_3DPrinting/Shivling/Insert_2_4mm.3mf

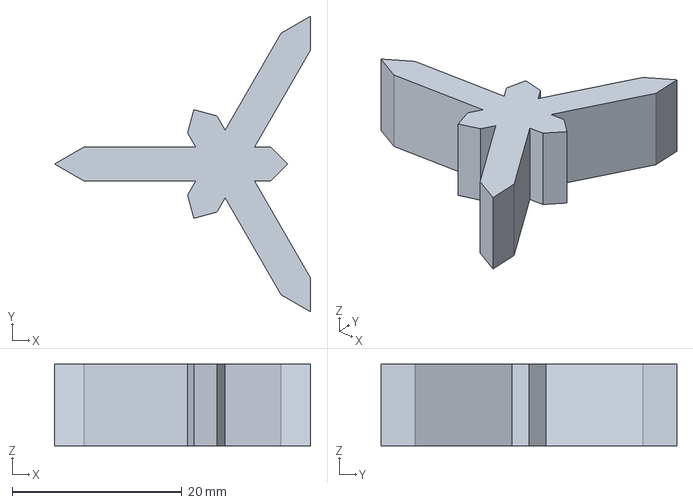
[picture p177: CAD file, 2026-07-20]
Shivling/Insert_2_4mm.3mf
30.1 x 34.8 x 9.60 mm
