shivamchudasama/KumikoFrame_3DPrinting/Shivling/Seams.3mf

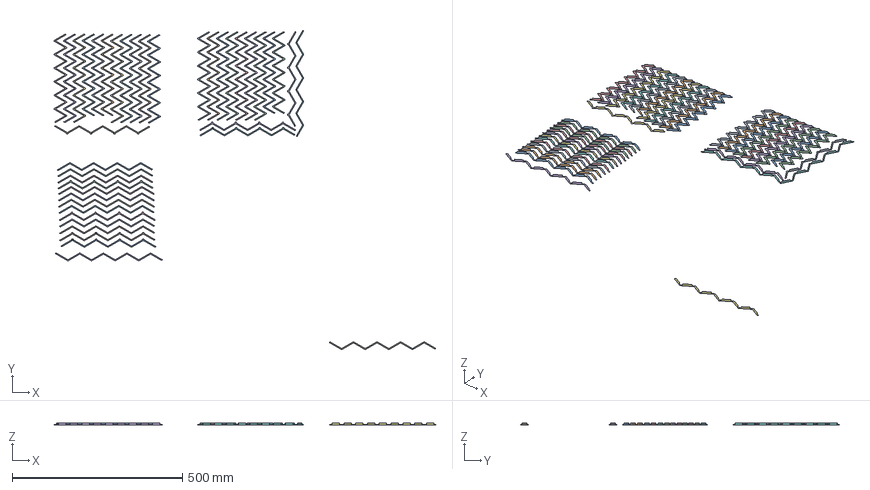
[picture p179: CAD file, 2026-07-20]
Shivling/Seams.3mf
1121.9 x 938.0 x 5.00 mm
Seams.stl_6
Seams.stl_9
Seams.stl_1
Seams.stl_4
Seams.stl_11
Seams.stl_14
Seams.stl_7
Seams.stl_10
Seams.stl_2
Seams.stl_5
Seams.stl_12
Seams.stl_15
Seams.stl_8
Seams.stl_3
Seams.stl_13
Seams.stl_16
Seams.stl_19
Seams.stl_17
Seams.stl_20
Seams.stl_18
Seams.stl_22
Seams.stl_21
Seams.stl_23
Seams.stl_25
Seams.stl_24
Seams.stl_26
Seams.stl_27
Seams.stl_28
Seams.stl_29
Seams.stl_31
Seams.stl_30
Seams.stl_32
Seams.stl_36
Seams.stl_33
Seams.stl_37
Seams.stl_34
Seams.stl_35
Seams.stl_38
Seams.stl_39
Seams.stl_40
