shivamchudasama/KumikoFrame_3DPrinting/Shivling/Insert_40_4mm.stl

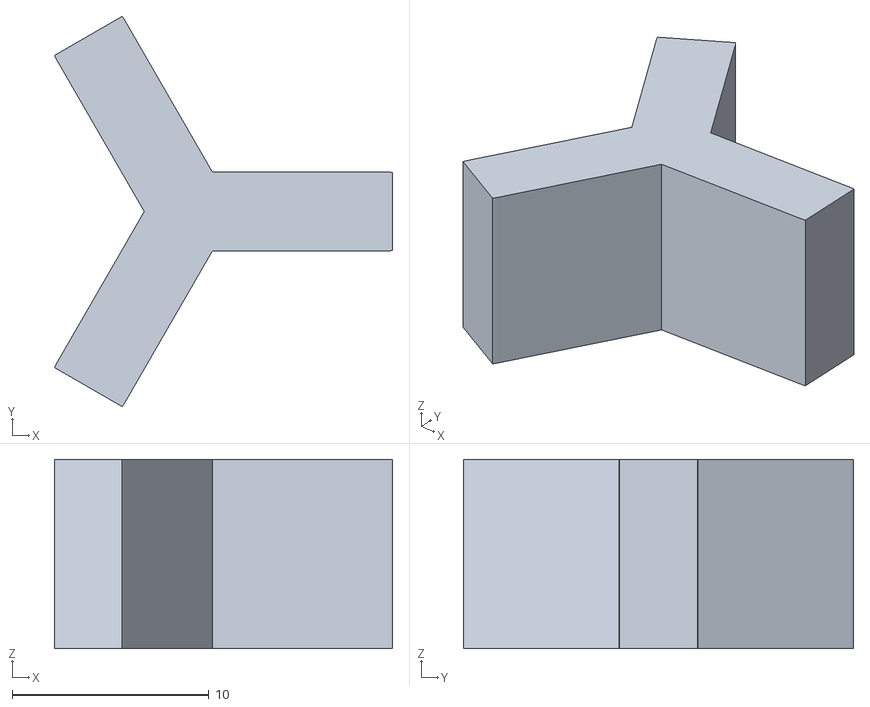
[picture p180: CAD file, 2026-07-20]
Shivling/Insert_40_4mm.stl
17.2 x 19.8 x 9.60
