shivamchudasama/KumikoFrame_3DPrinting/Shivling/Hanger.3mf

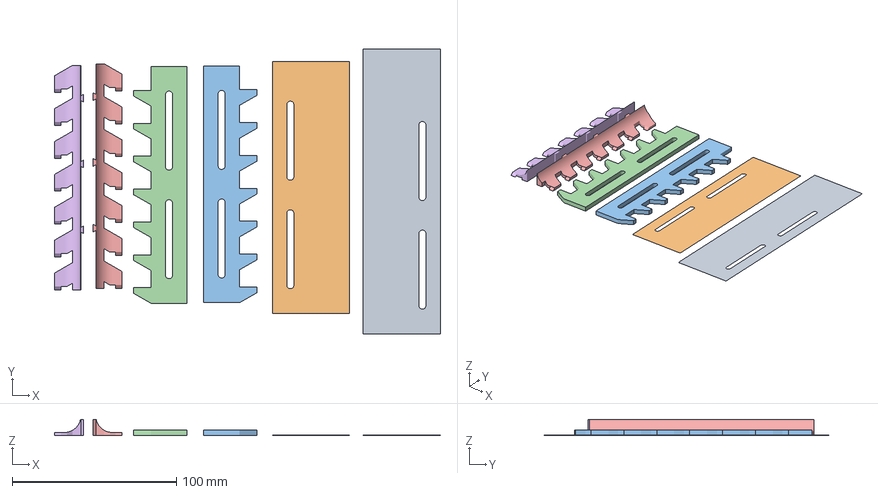
[picture p181: CAD file, 2026-07-20]
Shivling/Hanger.3mf
234.7 x 173.0 x 10.0 mm
Hanger.stl_4
Hanger.stl_6
Hanger.stl_2
Hanger.stl_3
Hanger.stl_1
Hanger.stl_5
