shivamchudasama/KumikoFrame_3DPrinting/Shivling/Outer Frame.3mf

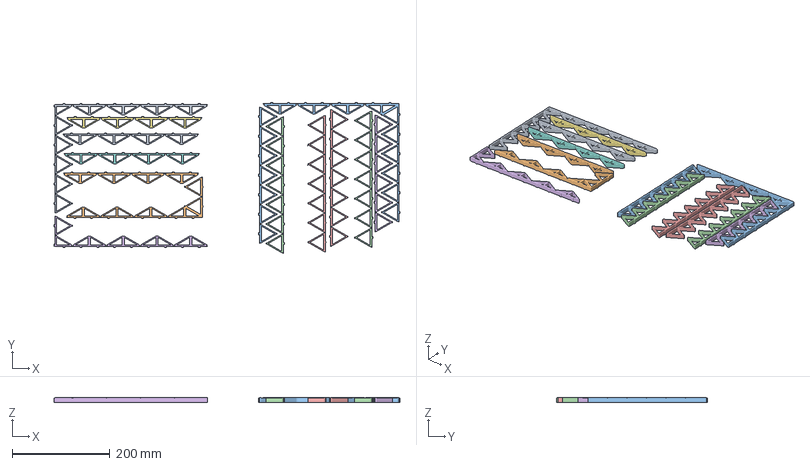
[picture p182: CAD file, 2026-07-20]
Shivling/Outer Frame.3mf
709.1 x 308.8 x 10.0 mm
Outer Frame.stl_1
Outer Frame.stl_2
Outer Frame.stl_3
Outer Frame.stl_4
Outer Frame.stl_5
Outer Frame.stl_6
Outer Frame.stl_7
Outer Frame.stl_8
Outer Frame.stl_9
Outer Frame.stl_10
Outer Frame.stl_11
Outer Frame.stl_12
Outer Frame.stl_13
Outer Frame.stl_14
