shivamchudasama/KumikoFrame_3DPrinting/Shivling/Insert_19_4mm.3mf

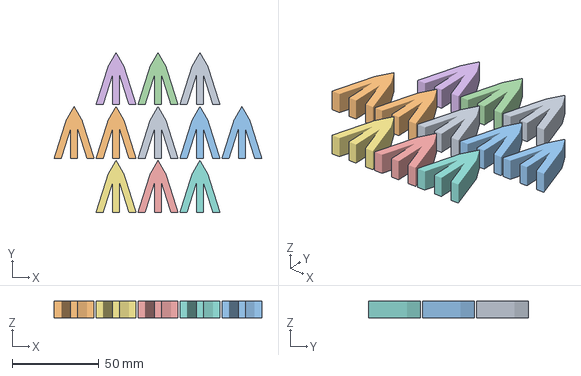
[picture p183: CAD file, 2026-07-20]
Shivling/Insert_19_4mm.3mf
120.2 x 92.4 x 9.60 mm
Insert_19_4mm.stl x 11
