shivamchudasama/KumikoFrame_3DPrinting/Shivling/Kumiko_Stamper.3mf

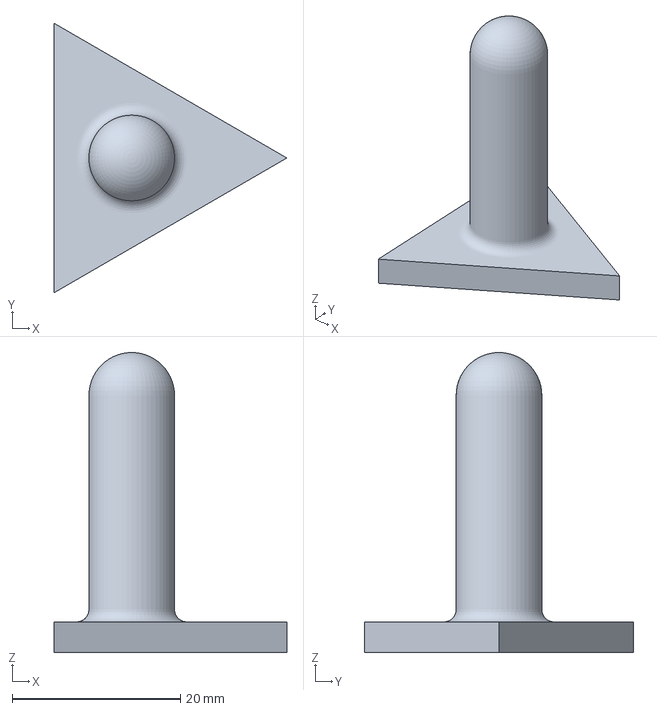
[picture p184: CAD file, 2026-07-20]
Shivling/Kumiko_Stamper.3mf
27.6 x 32.0 x 35.6 mm
