shivamchudasama/KumikoFrame_3DPrinting/Shivling/Boarder Background.3mf

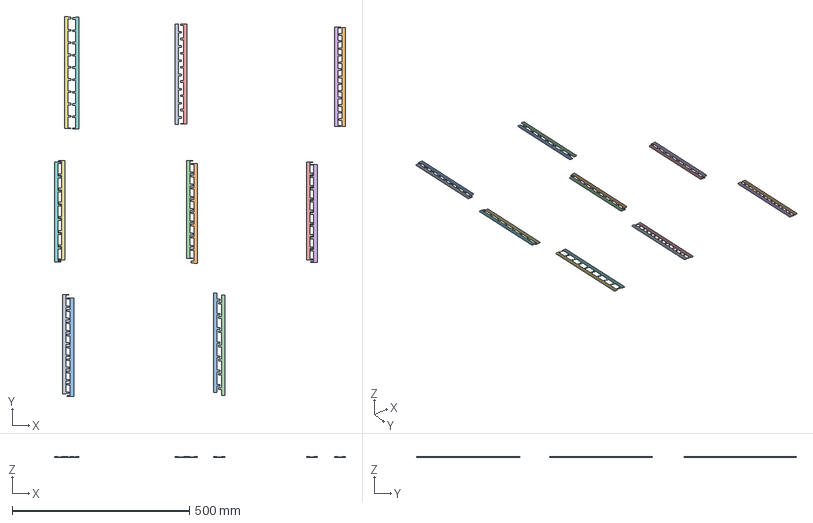
[picture p185: CAD file, 2026-07-20]
Shivling/Boarder Background.3mf
821.1 x 1071.8 x 3.01 mm
Boarder Background.stl_1
Boarder Background.stl_2
Boarder Background.stl_3
Boarder Background.stl_4
Boarder Background.stl_5
Boarder Background.stl_6
Boarder Background.stl_7
Boarder Background.stl_8
Boarder Background.stl_9
Boarder Background.stl_10
Boarder Background.stl_11
Boarder Background.stl_12
Boarder Background.stl_13
Boarder Background.stl_14
Boarder Background.stl_15
Boarder Background.stl_16
