shivamchudasama/KumikoFrame_3DPrinting/Shivling/Insert_0_4mm.stl

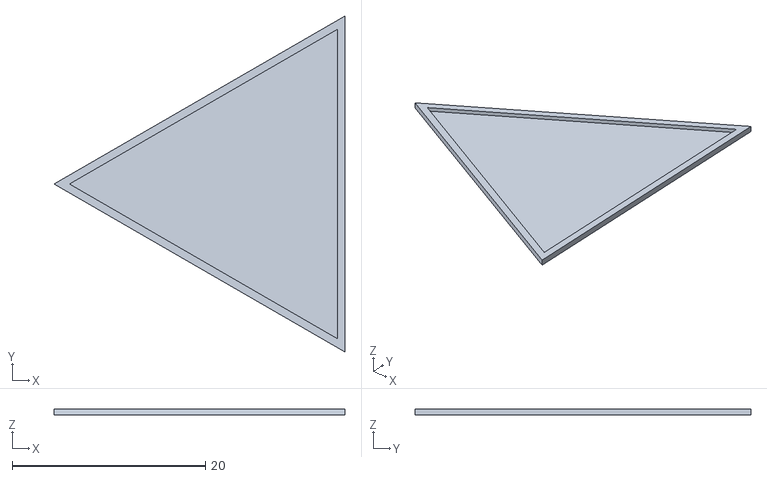
[picture p186: CAD file, 2026-07-20]
Shivling/Insert_0_4mm.stl
30.1 x 34.8 x 0.6
