shivamchudasama/KumikoFrame_3DPrinting/Shivling/Boarder_And_Boarder_Background.stl

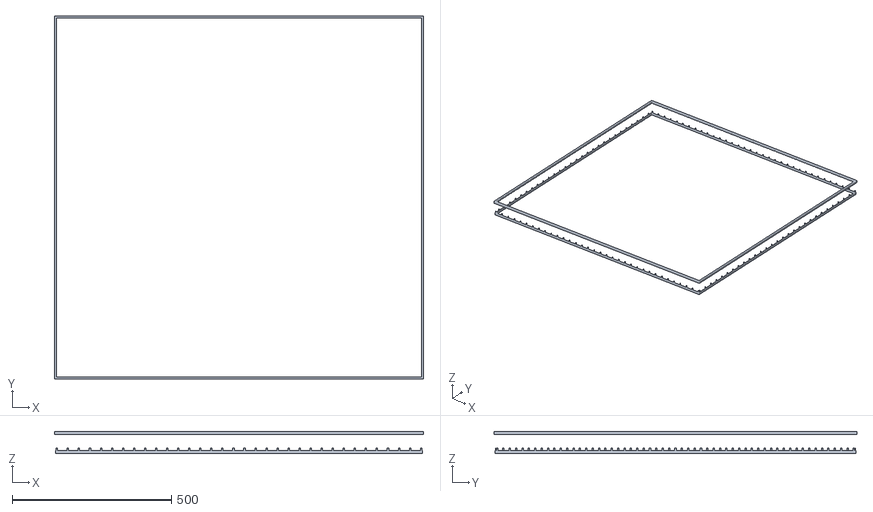
[picture p187: CAD file, 2026-07-20]
Shivling/Boarder_And_Boarder_Background.stl
1158.2 x 1138.0 x 70.0
