shivamchudasama/KumikoFrame_3DPrinting/Shivling/Insert_1_4mm.3mf

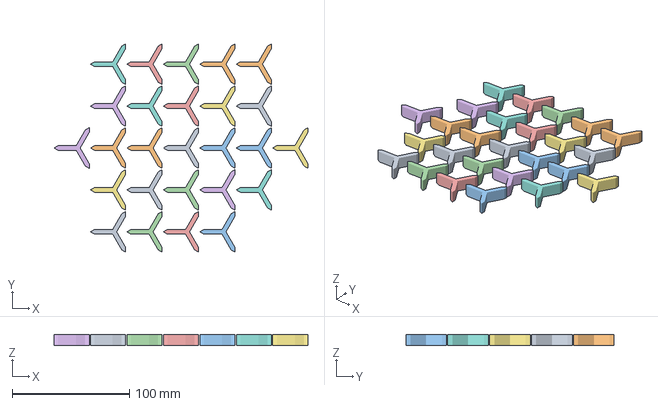
[picture p188: CAD file, 2026-07-20]
Shivling/Insert_1_4mm.3mf
217.0 x 178.0 x 9.60 mm
Insert_1_4mm.stl x 26
