shivamchudasama/KumikoFrame_3DPrinting/Shivling/Subpanels.3mf

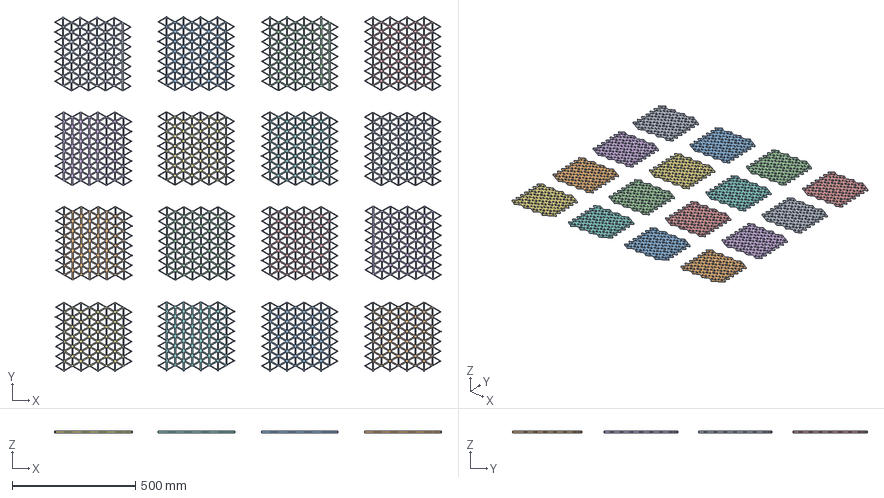
[picture p189: CAD file, 2026-07-09]
Shivling/Subpanels.3mf
1572.8 x 1443.3 x 10.0 mm
Subpanels.stl_1
Subpanels.stl_2
Subpanels.stl_3
Subpanels.stl_4
Subpanels.stl_5
Subpanels.stl_6
Subpanels.stl_7
Subpanels.stl_8
Subpanels.stl_9
Subpanels.stl_10
Subpanels.stl_11
Subpanels.stl_12
Subpanels.stl_13
Subpanels.stl_14
Subpanels.stl_15
Subpanels.stl_16
