shivamchudasama/KumikoFrame_3DPrinting/(list of files, cad)

Other CAD files:
Source Code/svg_insert_generator.scad
Print Profiles & STLs/V1 - Primary Panel/STLs/Background Inserts.stl
Print Profiles & STLs/V1 - Primary Panel/STLs/Frame Components.stl
Print Profiles & STLs/V1 - Secondary Panels/STLs/Background Inserts.stl
Print Profiles & STLs/V1 - Secondary Panels/STLs/Frame Components.stl
Print Profiles & STLs/V1 - Secondary Panels/STLs/Pattern Inserts - Large Hexagon.stl
Print Profiles & STLs/V1 - Secondary Panels/STLs/Pattern Inserts - Mountains.stl
Print Profiles & STLs/V1 - Secondary Panels/STLs/Pattern Inserts - Symmetry.stl
Print Profiles & STLs/V2 - Fjallbo Compatible/STLs/Background Inserts__Optional.stl
Print Profiles & STLs/V2 - Fjallbo Compatible/STLs/Frame Components.stl
Print Profiles & STLs/V2 - Fjallbo Compatible/STLs/Pattern Inserts.stl
Print Profiles & STLs/V2 - Gorilla Shelf Compatible/STLs/Background Components.stl
Print Profiles & STLs/V2 - Gorilla Shelf Compatible/STLs/Frame Components.stl
Print Profiles & STLs/V2 - Primary Panel & Alternatives/STLs/Background Inserts.stl
Print Profiles & STLs/V2 - Primary Panel & Alternatives/STLs/Frame Components.stl
Print Profiles & STLs/V2 - Primary Panel & Alternatives/STLs/Pattern Inserts Mountains.stl
Shivling/Boarder Background.stl
Shivling/Boarder.stl
Shivling/Hanger.stl
Shivling/Insert_19_4mm.stl
Shivling/Insert_1_4mm.stl
Shivling/Insert_2_4mm.stl
Shivling/Outer Frame.stl
Shivling/Seams.stl
Shivling/Subpanels.stl
