shivamchudasama/KumikoFrame_3DPrinting/Print Profiles & STLs/V1 - Primary Panel/Parameters.png

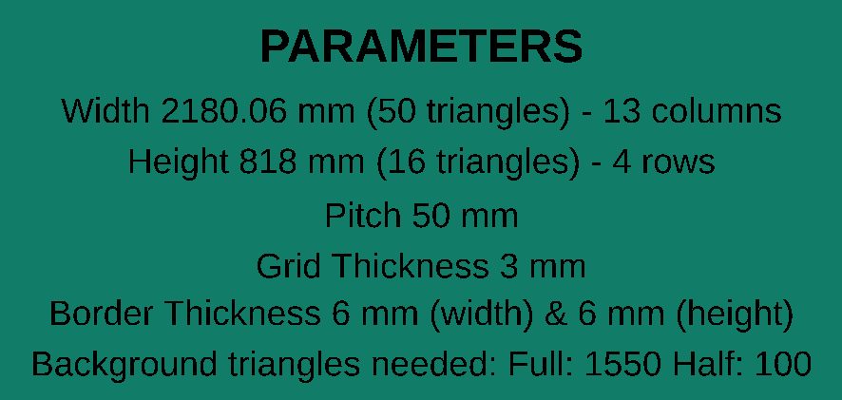
Print Profiles & STLs/V1 - Primary Panel/Parameters.png
