shivamchudasama/KumikoFrame_3DPrinting/Print Profiles & STLs/V1 - Secondary Panels/Parameters.png

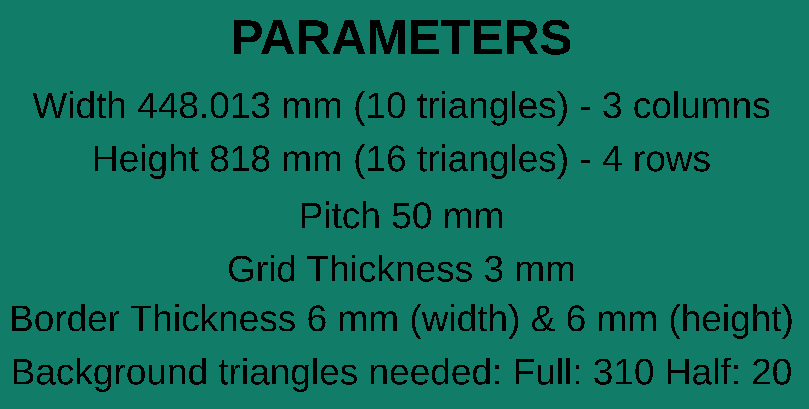
Print Profiles & STLs/V1 - Secondary Panels/Parameters.png
