shivamchudasama/KumikoFrame_3DPrinting/Print Profiles & STLs/V2 - Primary Panel & Alternatives/Parameters.png

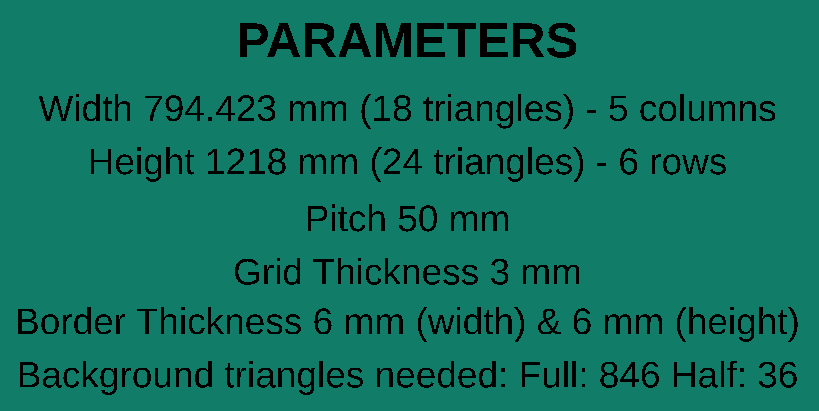
Print Profiles & STLs/V2 - Primary Panel & Alternatives/Parameters.png
