shivamchudasama/KumikoFrame_3DPrinting/Shivling/Referance Measurements.png

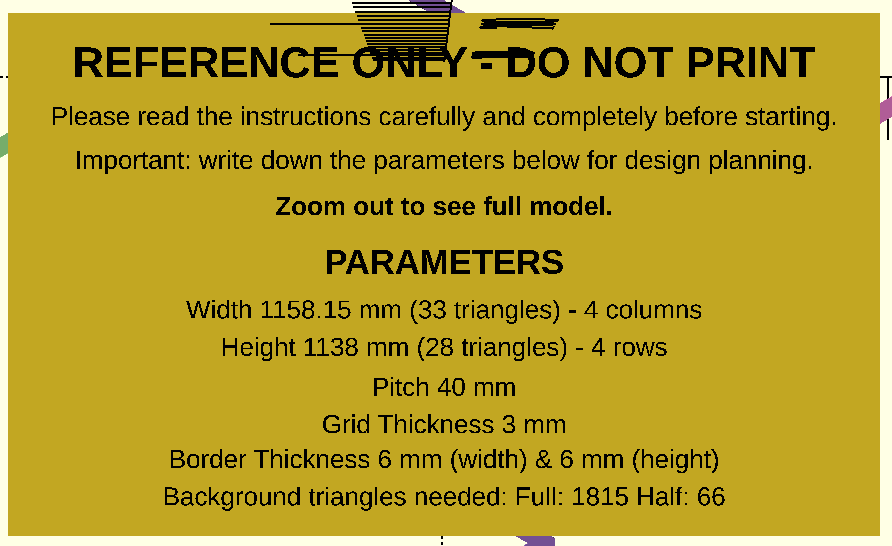
Shivling/Referance Measurements.png
