shivamchudasama/KumikoFrame_3DPrinting/Print Profiles & STLs/V1 - Primary Panel/Reference Image.pdf

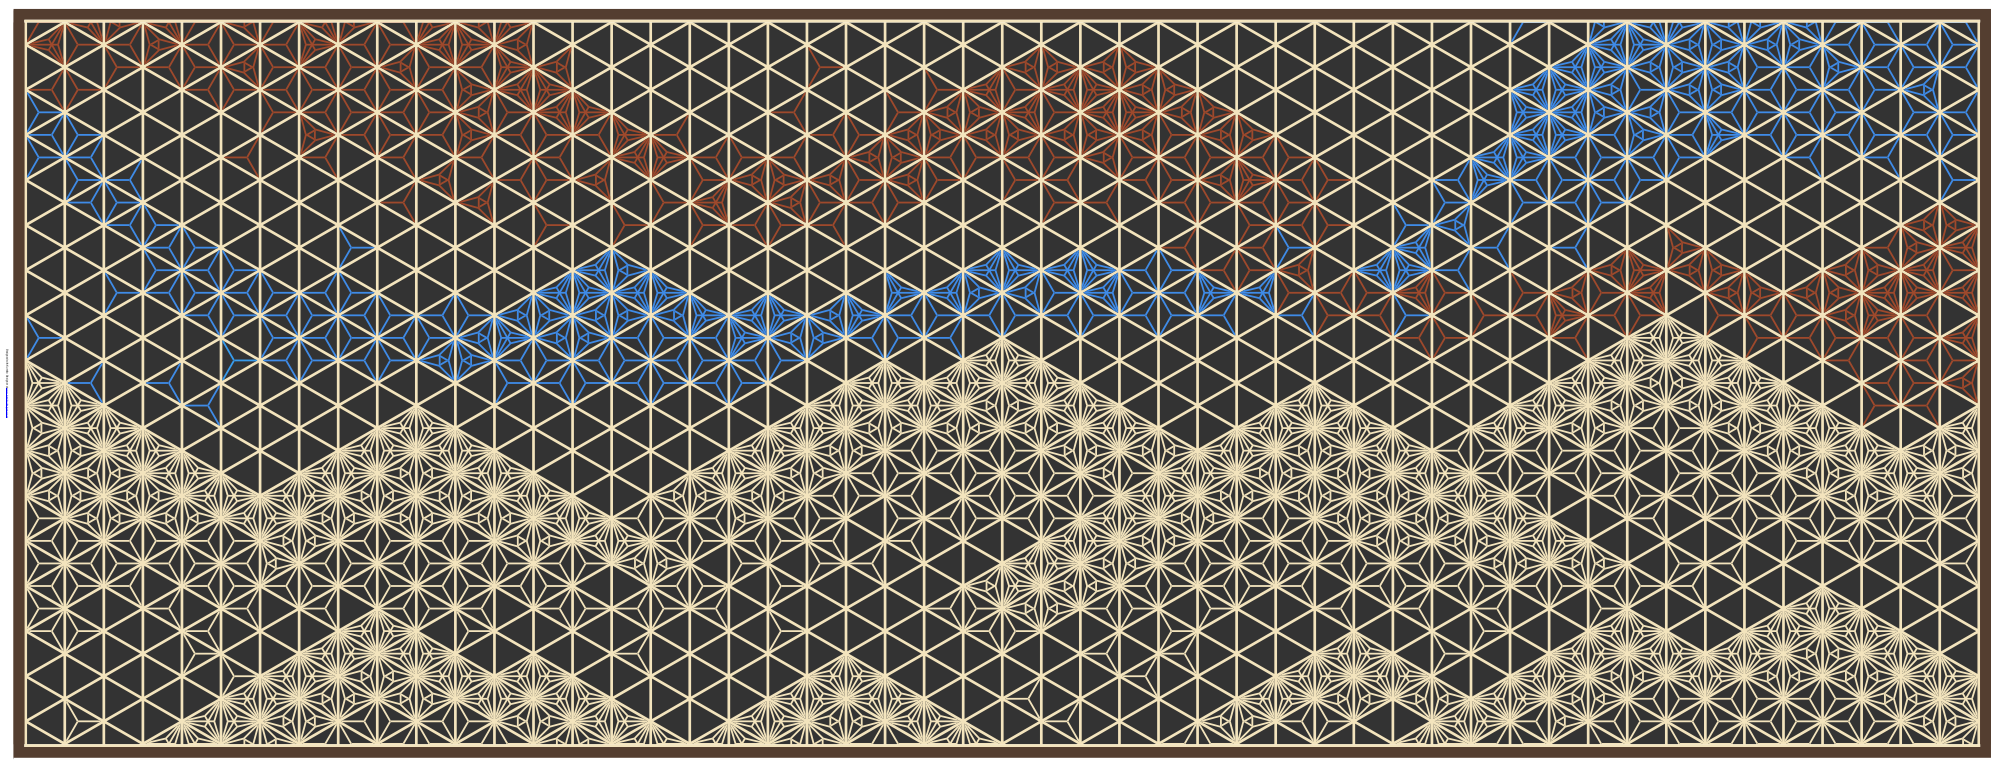
[picture p194: page 1]

Powered by TCPDF (www.tcpdf.org)

Designed with Kumiko Designer at www.kumikodesigner.com
