shivamchudasama/KumikoFrame_3DPrinting/Print Profiles & STLs/V1 - Secondary Panels/Hexagons.pdf

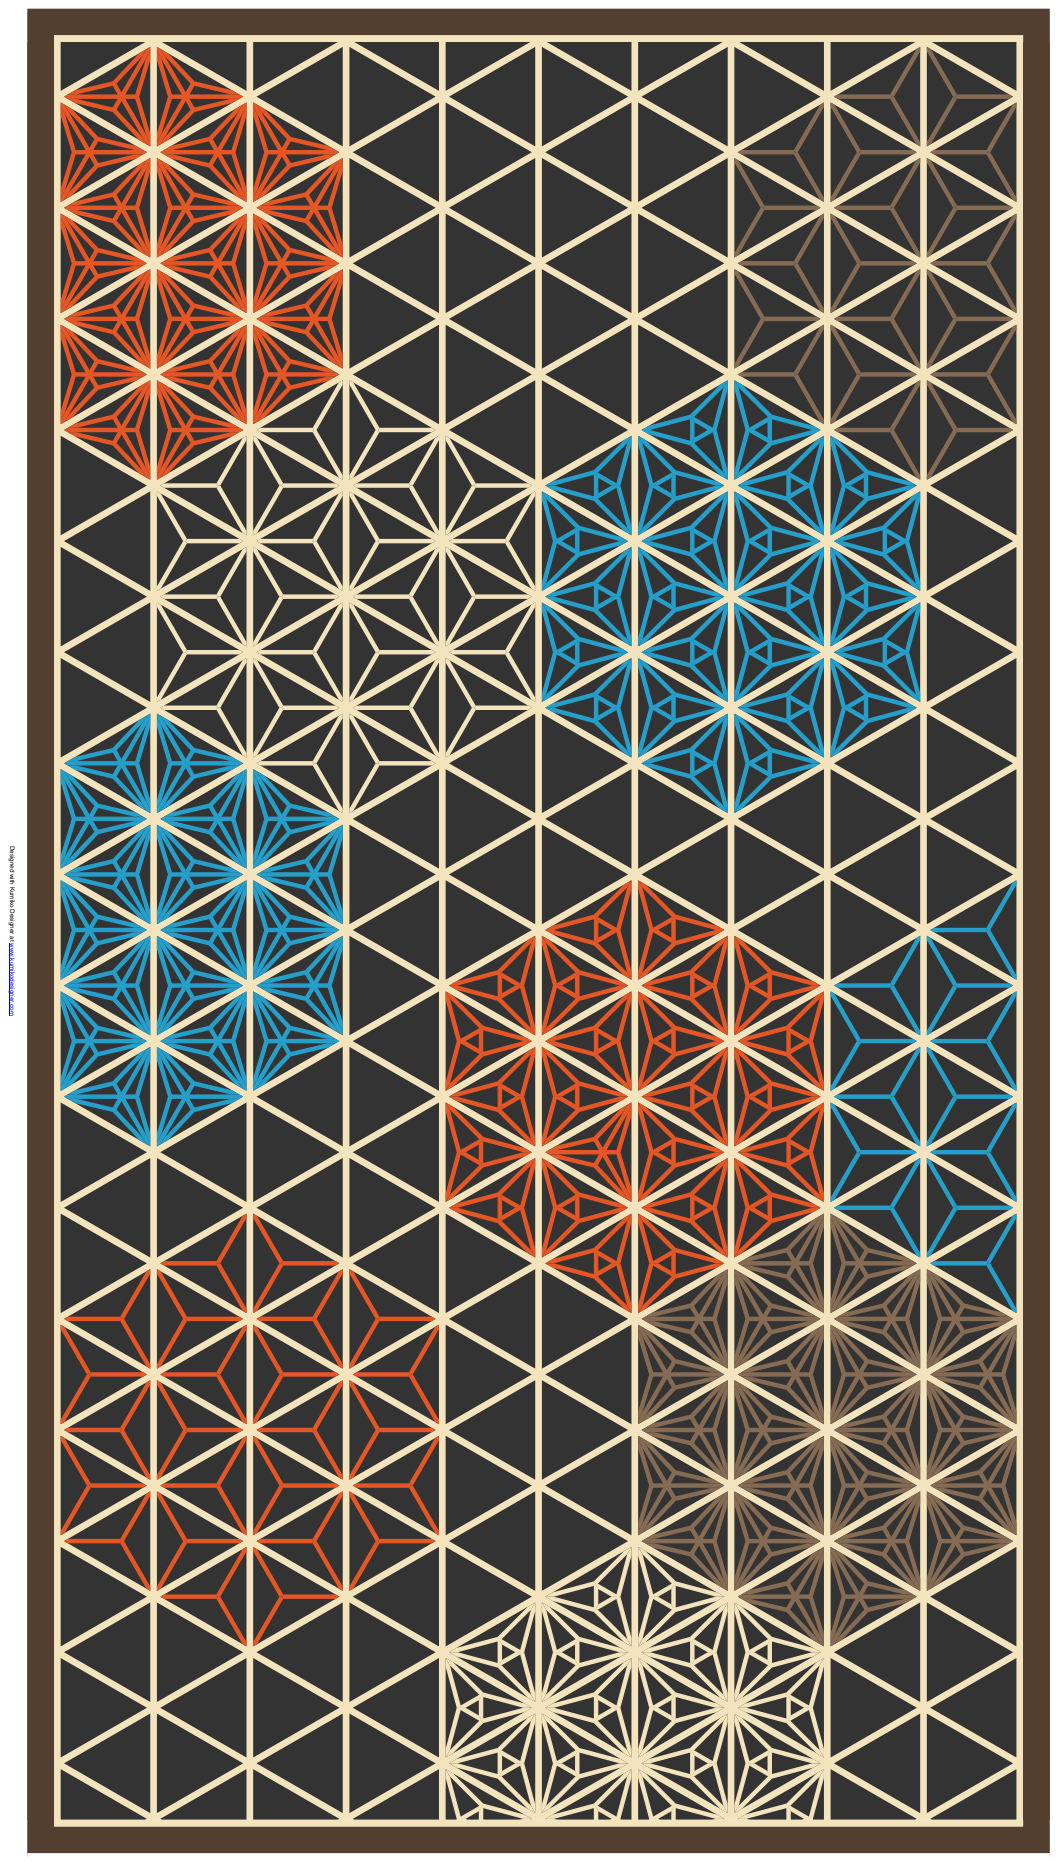
[picture p195: page 1]

Powered by TCPDF (www.tcpdf.org)

Designed with Kumiko Designer at www.kumikodesigner.com
