shivamchudasama/KumikoFrame_3DPrinting/Print Profiles & STLs/V1 - Secondary Panels/Mountains.pdf

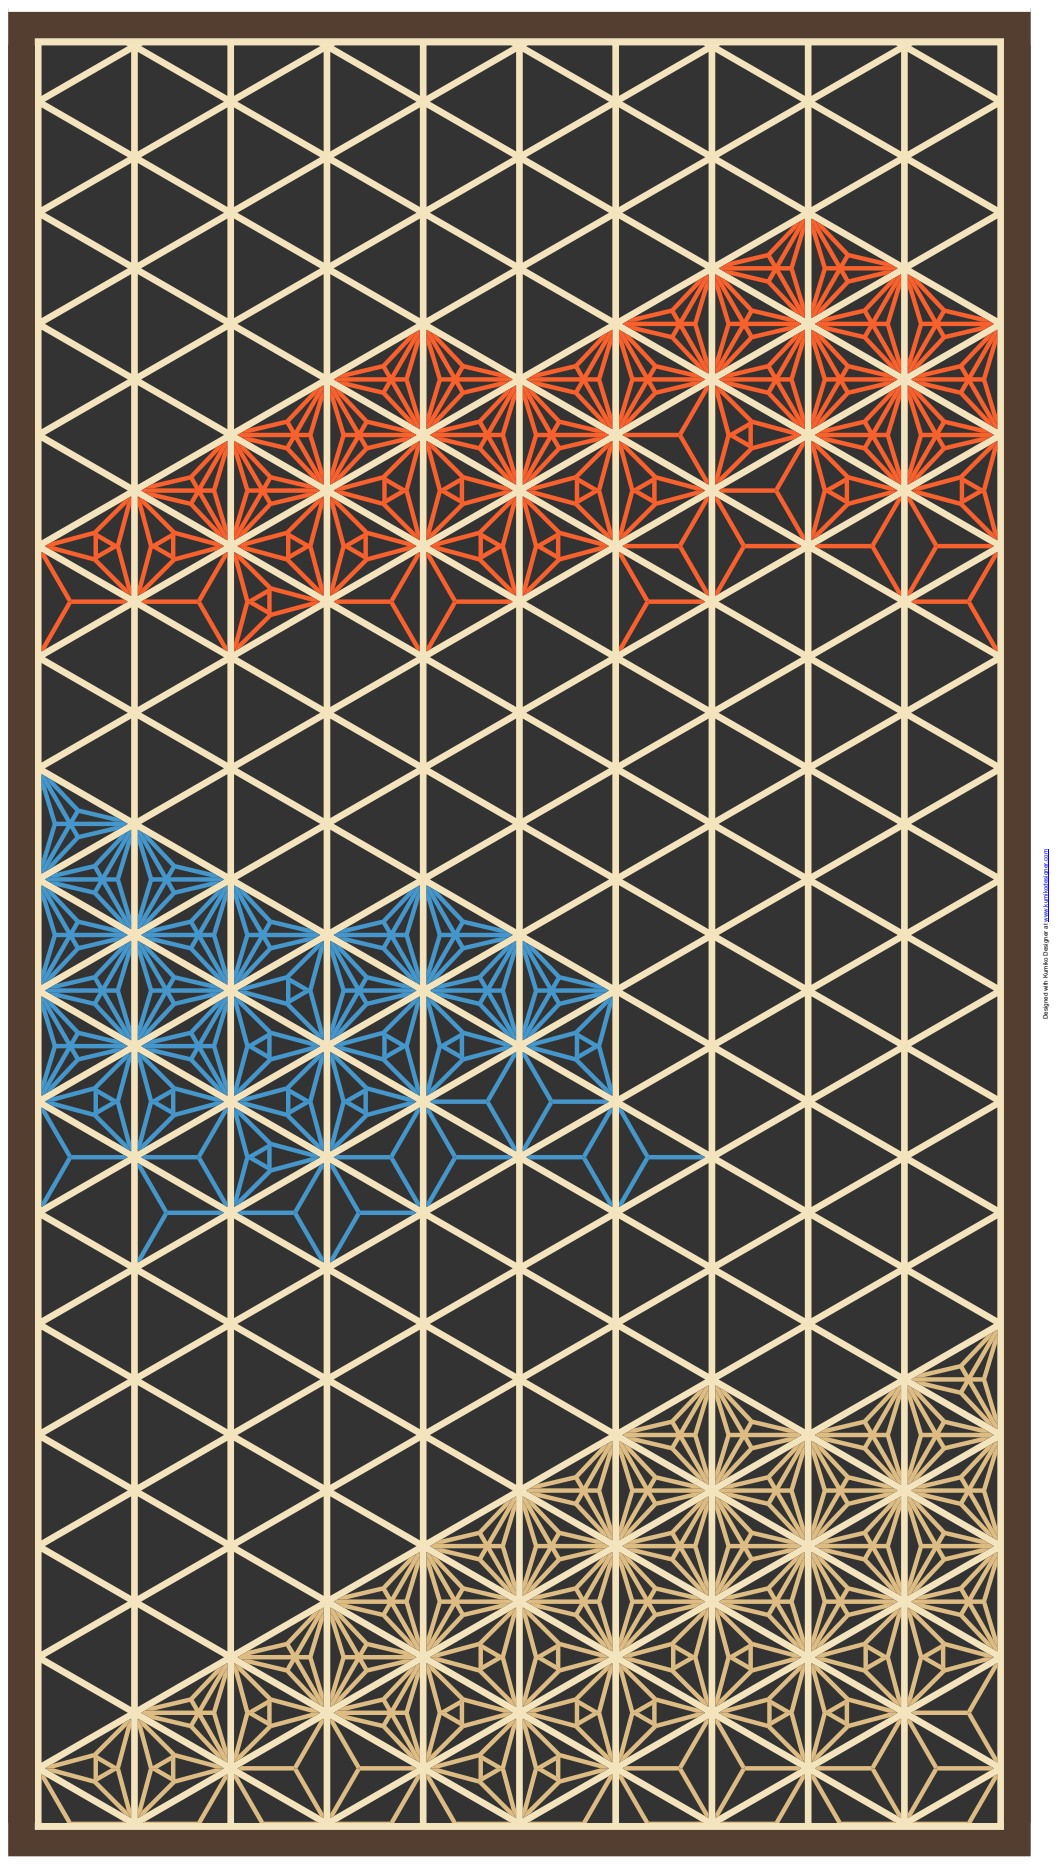
[picture p196: page 1]

Designed with Kumiko Designer at www.kumikodesigner.com

Powered by TCPDF (www.tcpdf.org)
