shivamchudasama/KumikoFrame_3DPrinting/Print Profiles & STLs/V1 - Secondary Panels/Symmetry.pdf

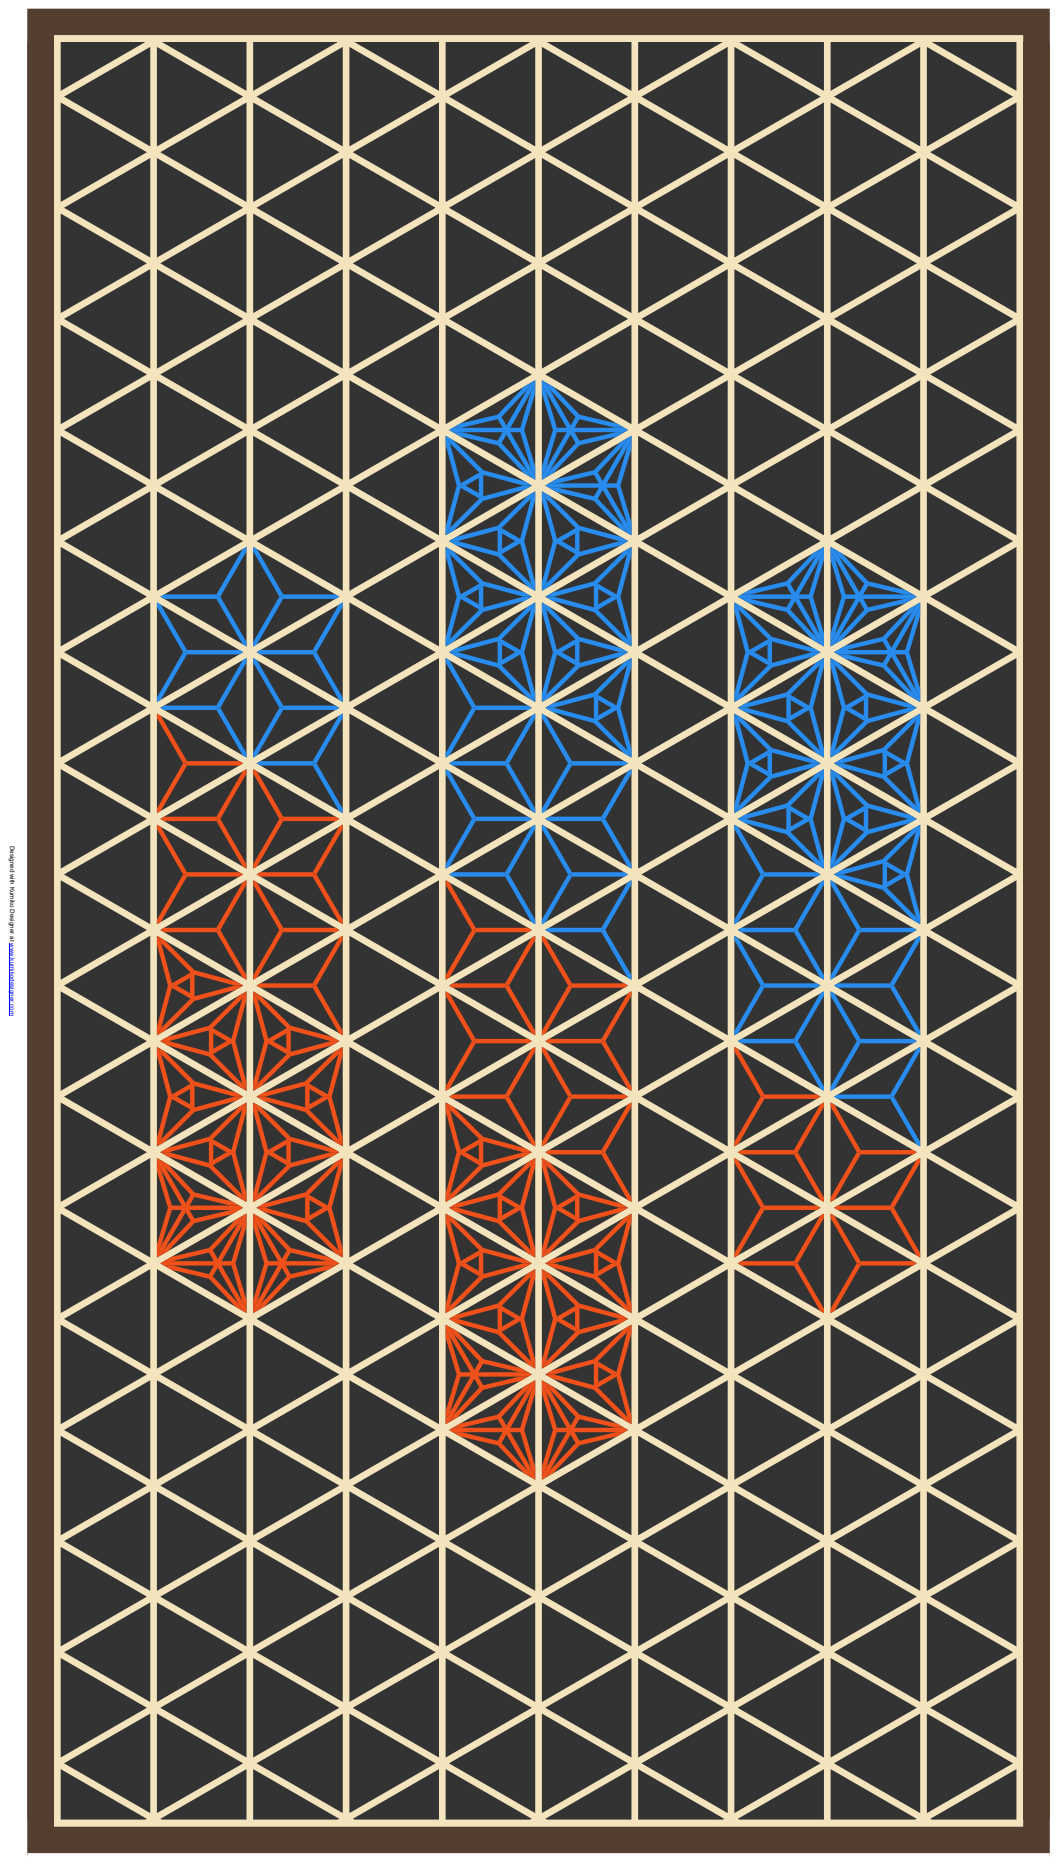
[picture p197: page 1]

Powered by TCPDF (www.tcpdf.org)

Designed with Kumiko Designer at www.kumikodesigner.com
