shivamchudasama/KumikoFrame_3DPrinting/Print Profiles & STLs/V2 - Fjallbo Compatible/Reference Image.pdf

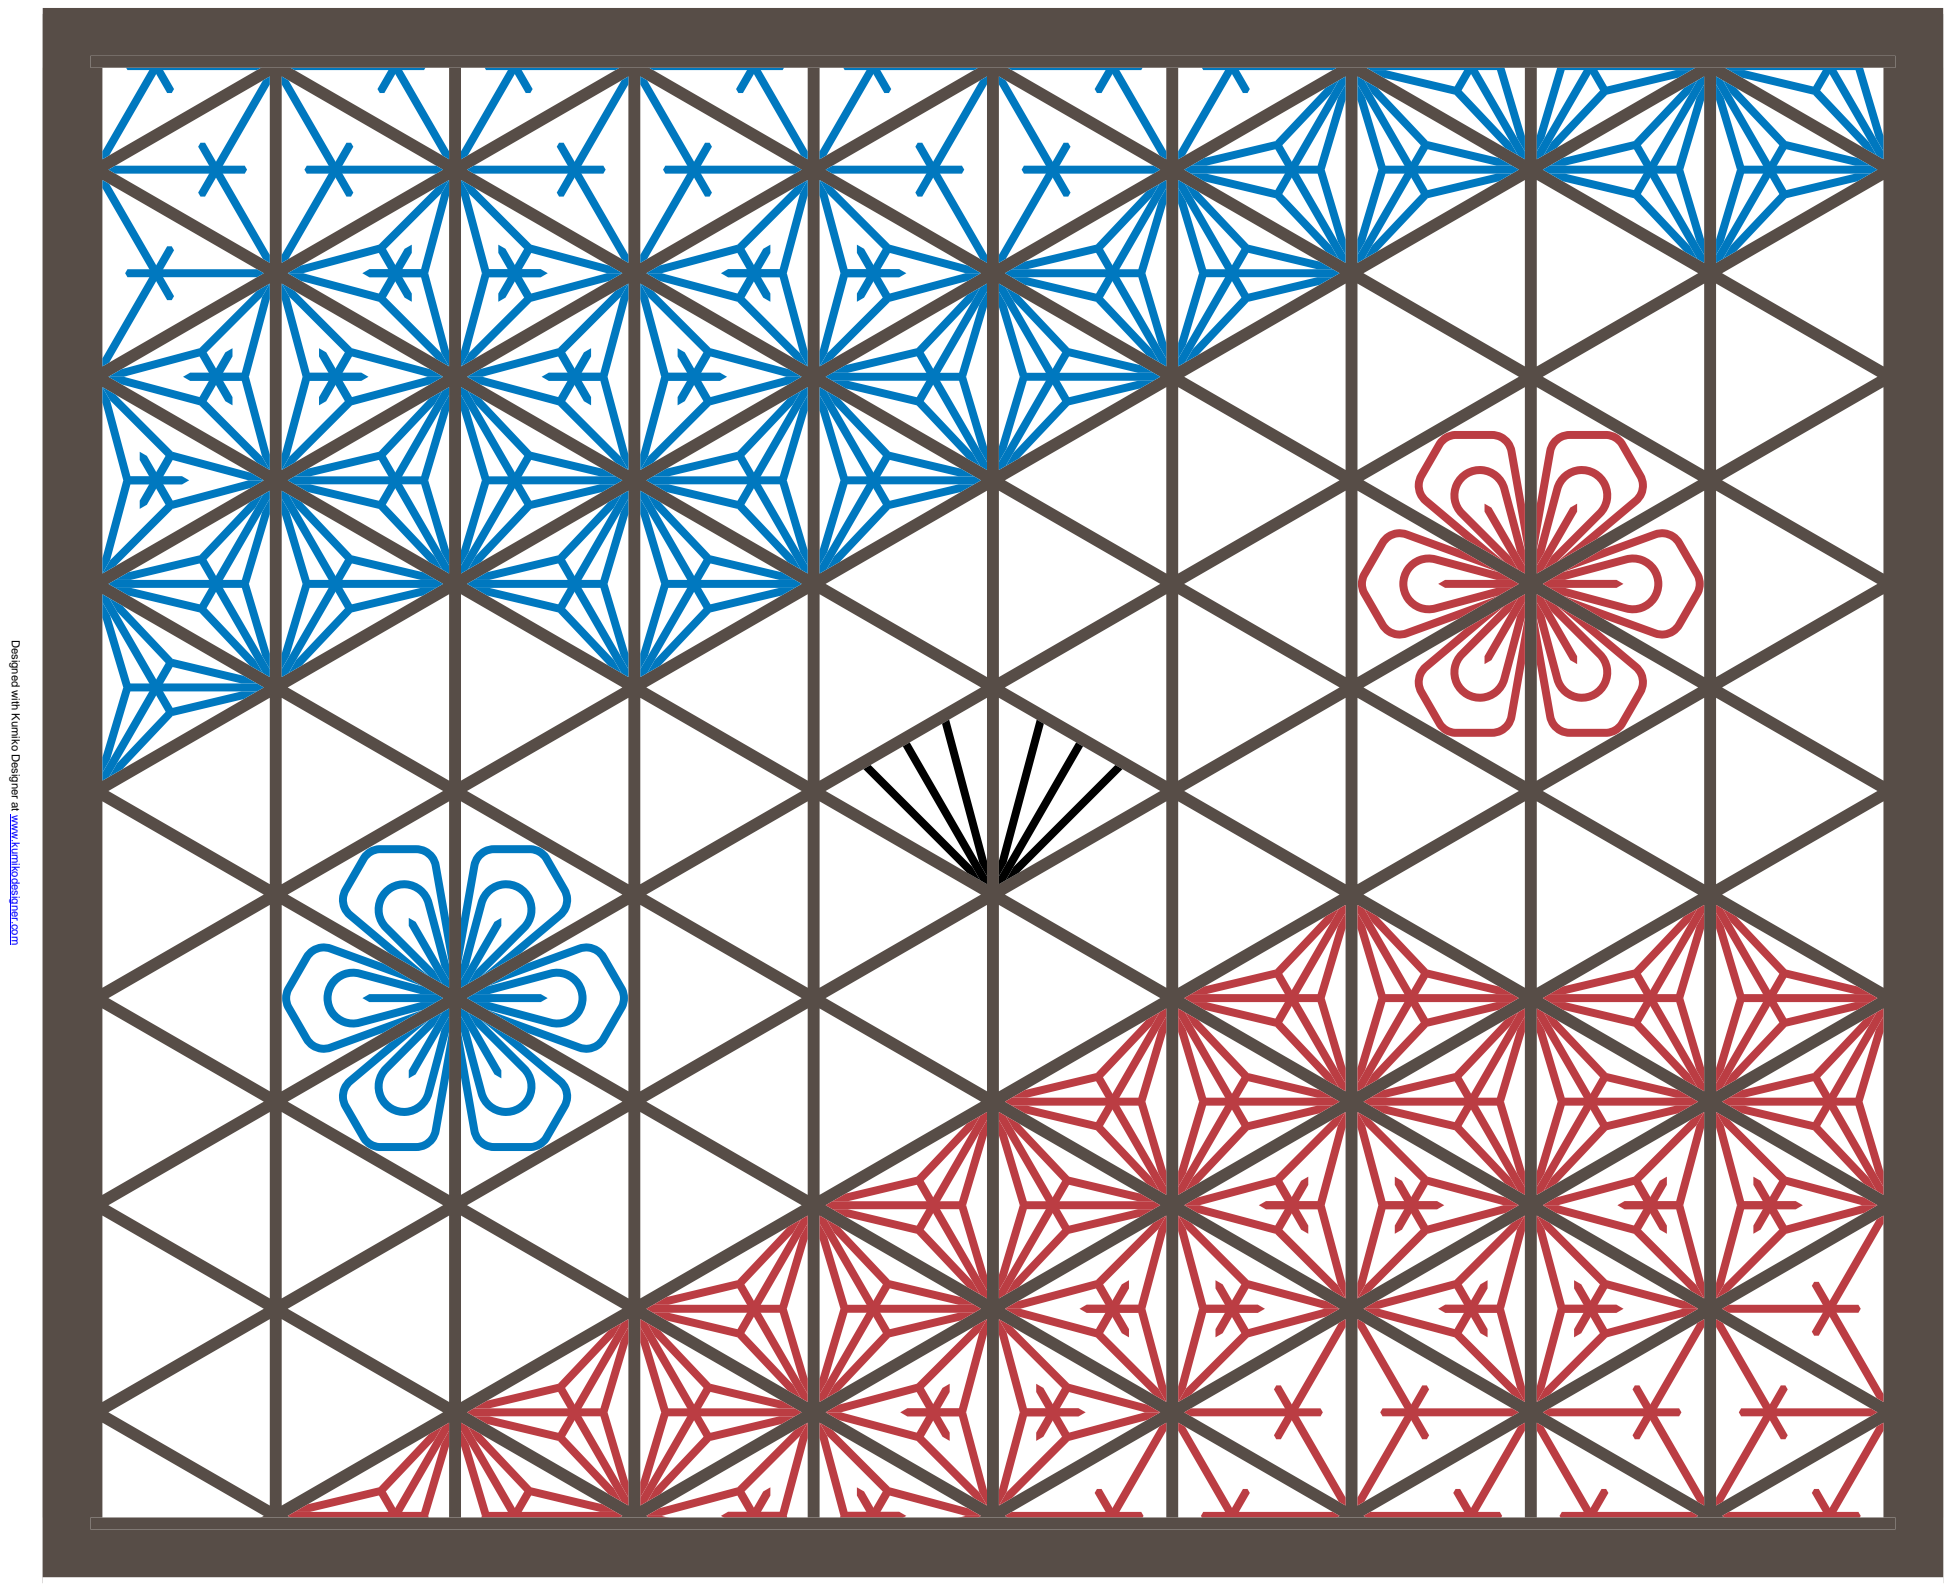
[picture p198: page 1]

Powered by TCPDF (www.tcpdf.org)

Designed with Kumiko Designer at www.kumikodesigner.com
