shivamchudasama/KumikoFrame_3DPrinting/Print Profiles & STLs/V2 - Gorilla Shelf Compatible/Reference Image.pdf

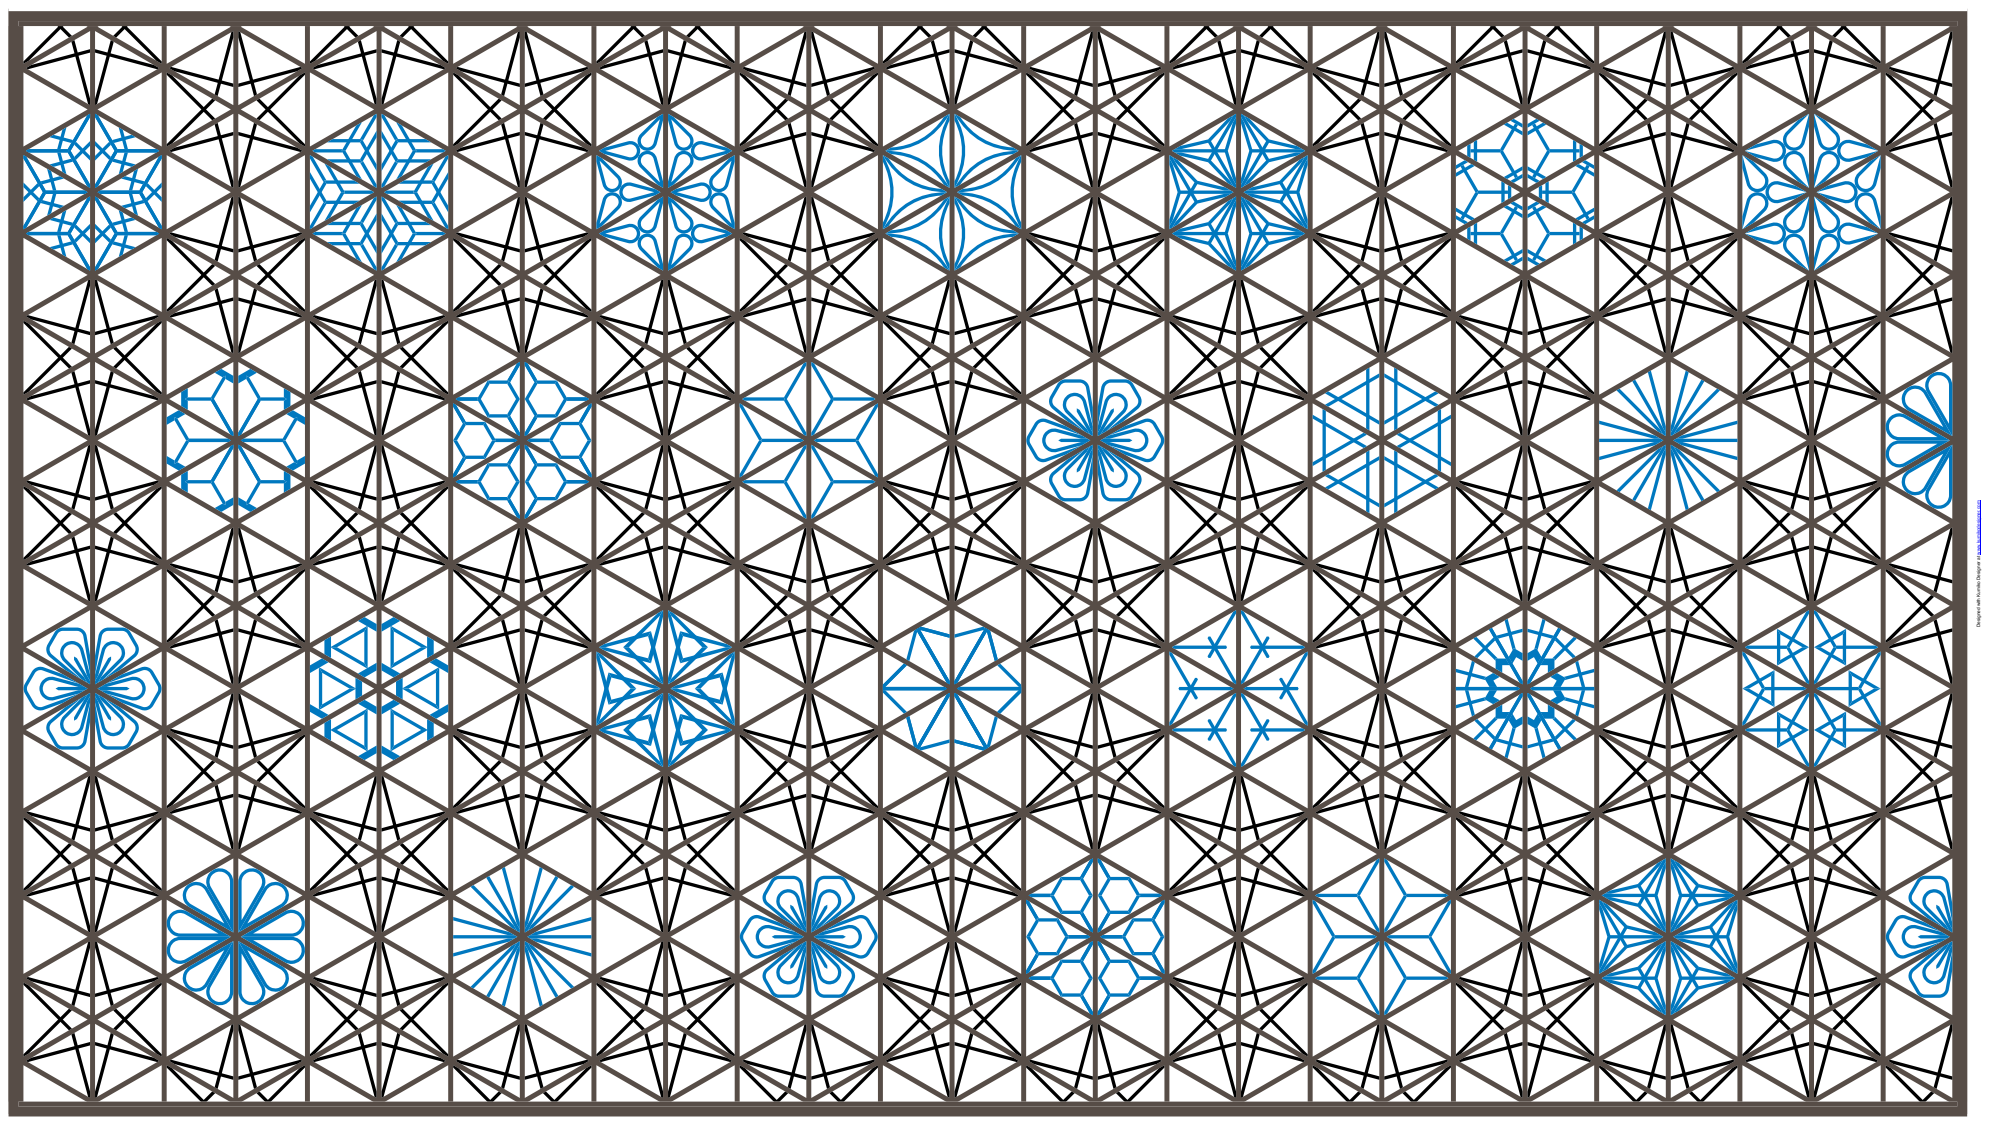
[picture p199: page 1]

Designed with Kumiko Designer at www.kumikodesigner.com

Powered by TCPDF (www.tcpdf.org)
