shivamchudasama/KumikoFrame_3DPrinting/Print Profiles & STLs/V2 - Primary Panel & Alternatives/Reference Image - Cubes.pdf

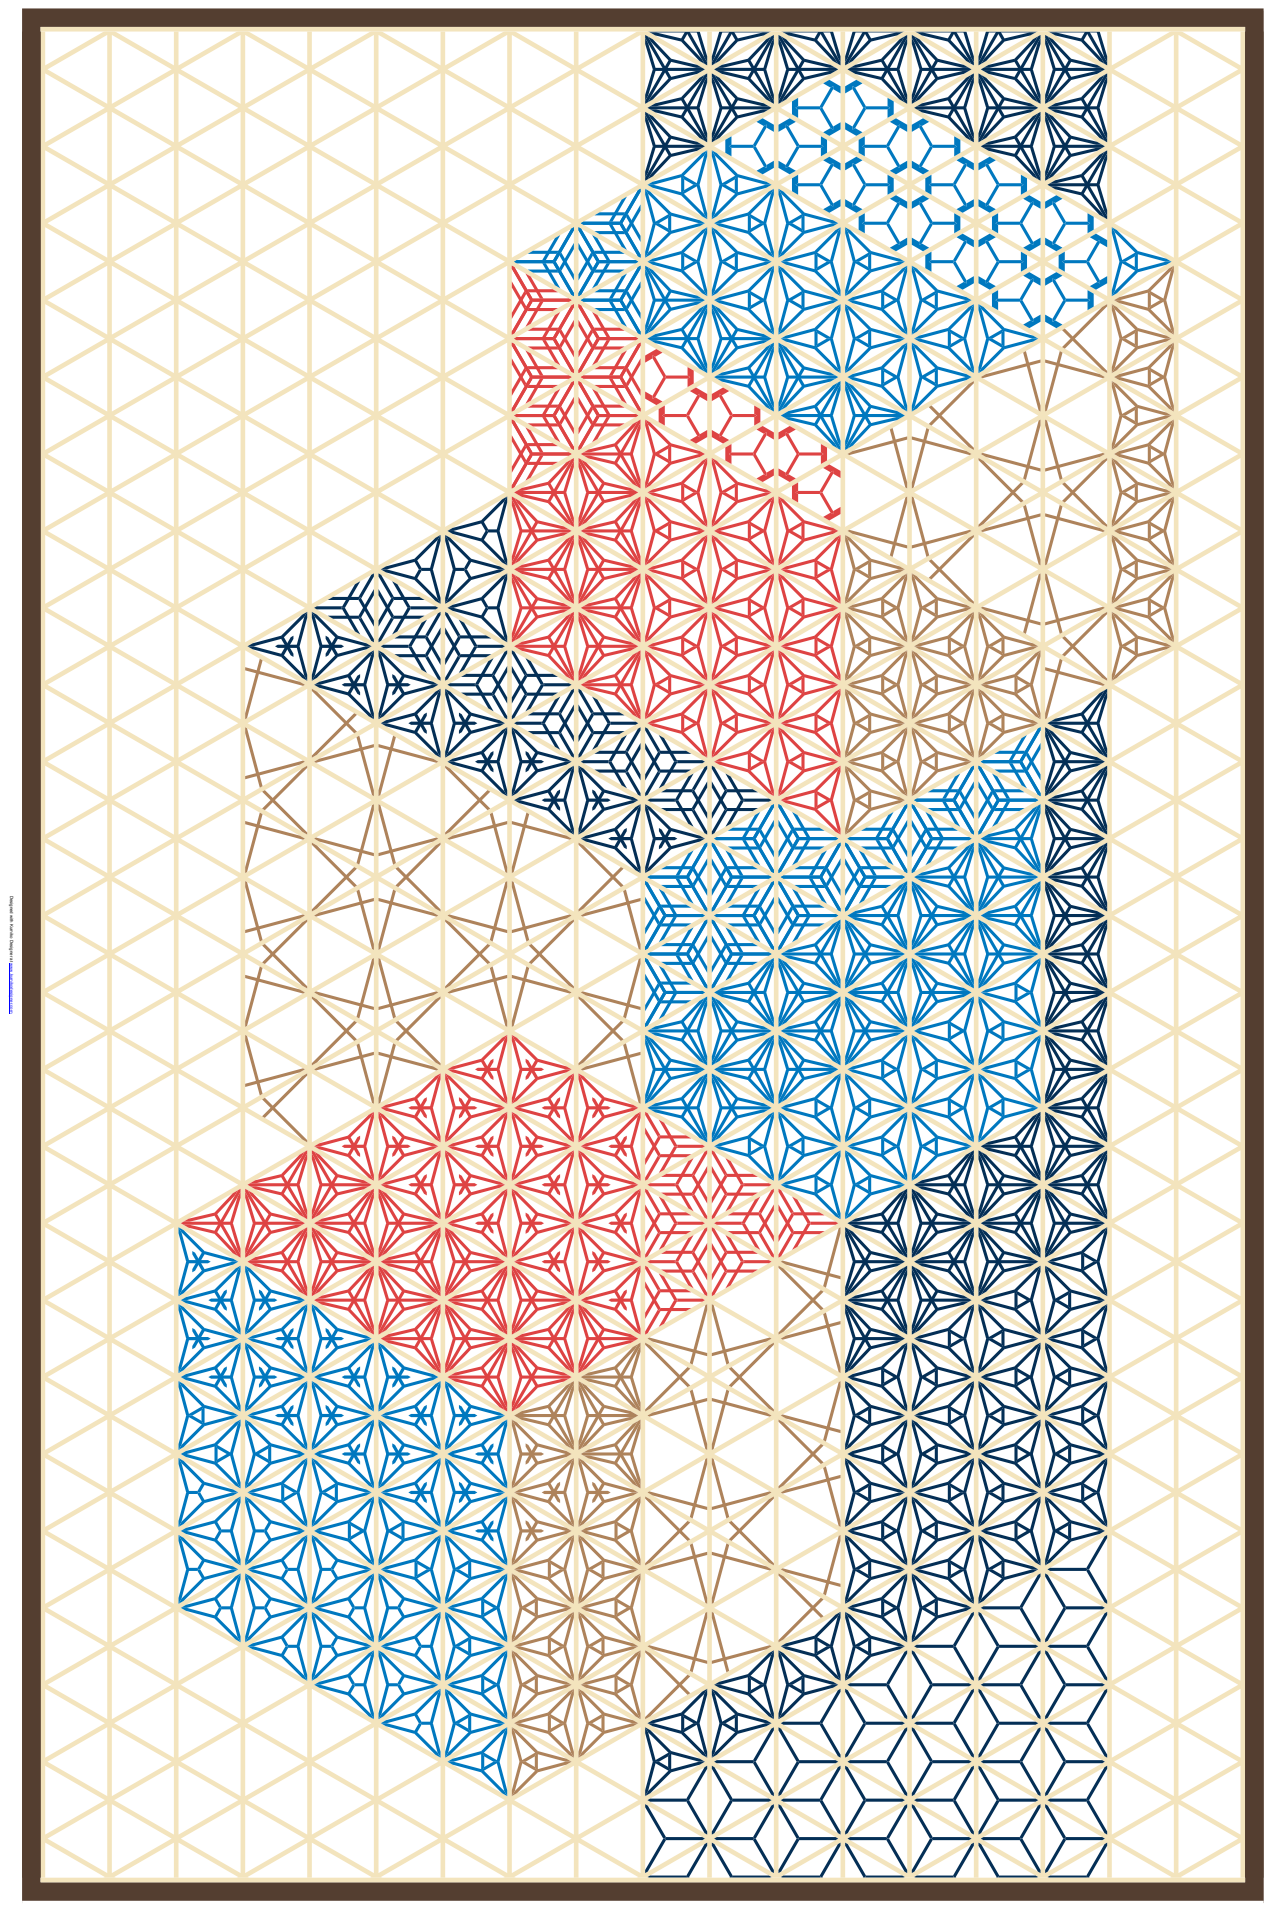
[picture p200: page 1]

Powered by TCPDF (www.tcpdf.org)

Designed with Kumiko Designer at www.kumikodesigner.com
