shivamchudasama/KumikoFrame_3DPrinting/Shivling/Shivling1.pdf

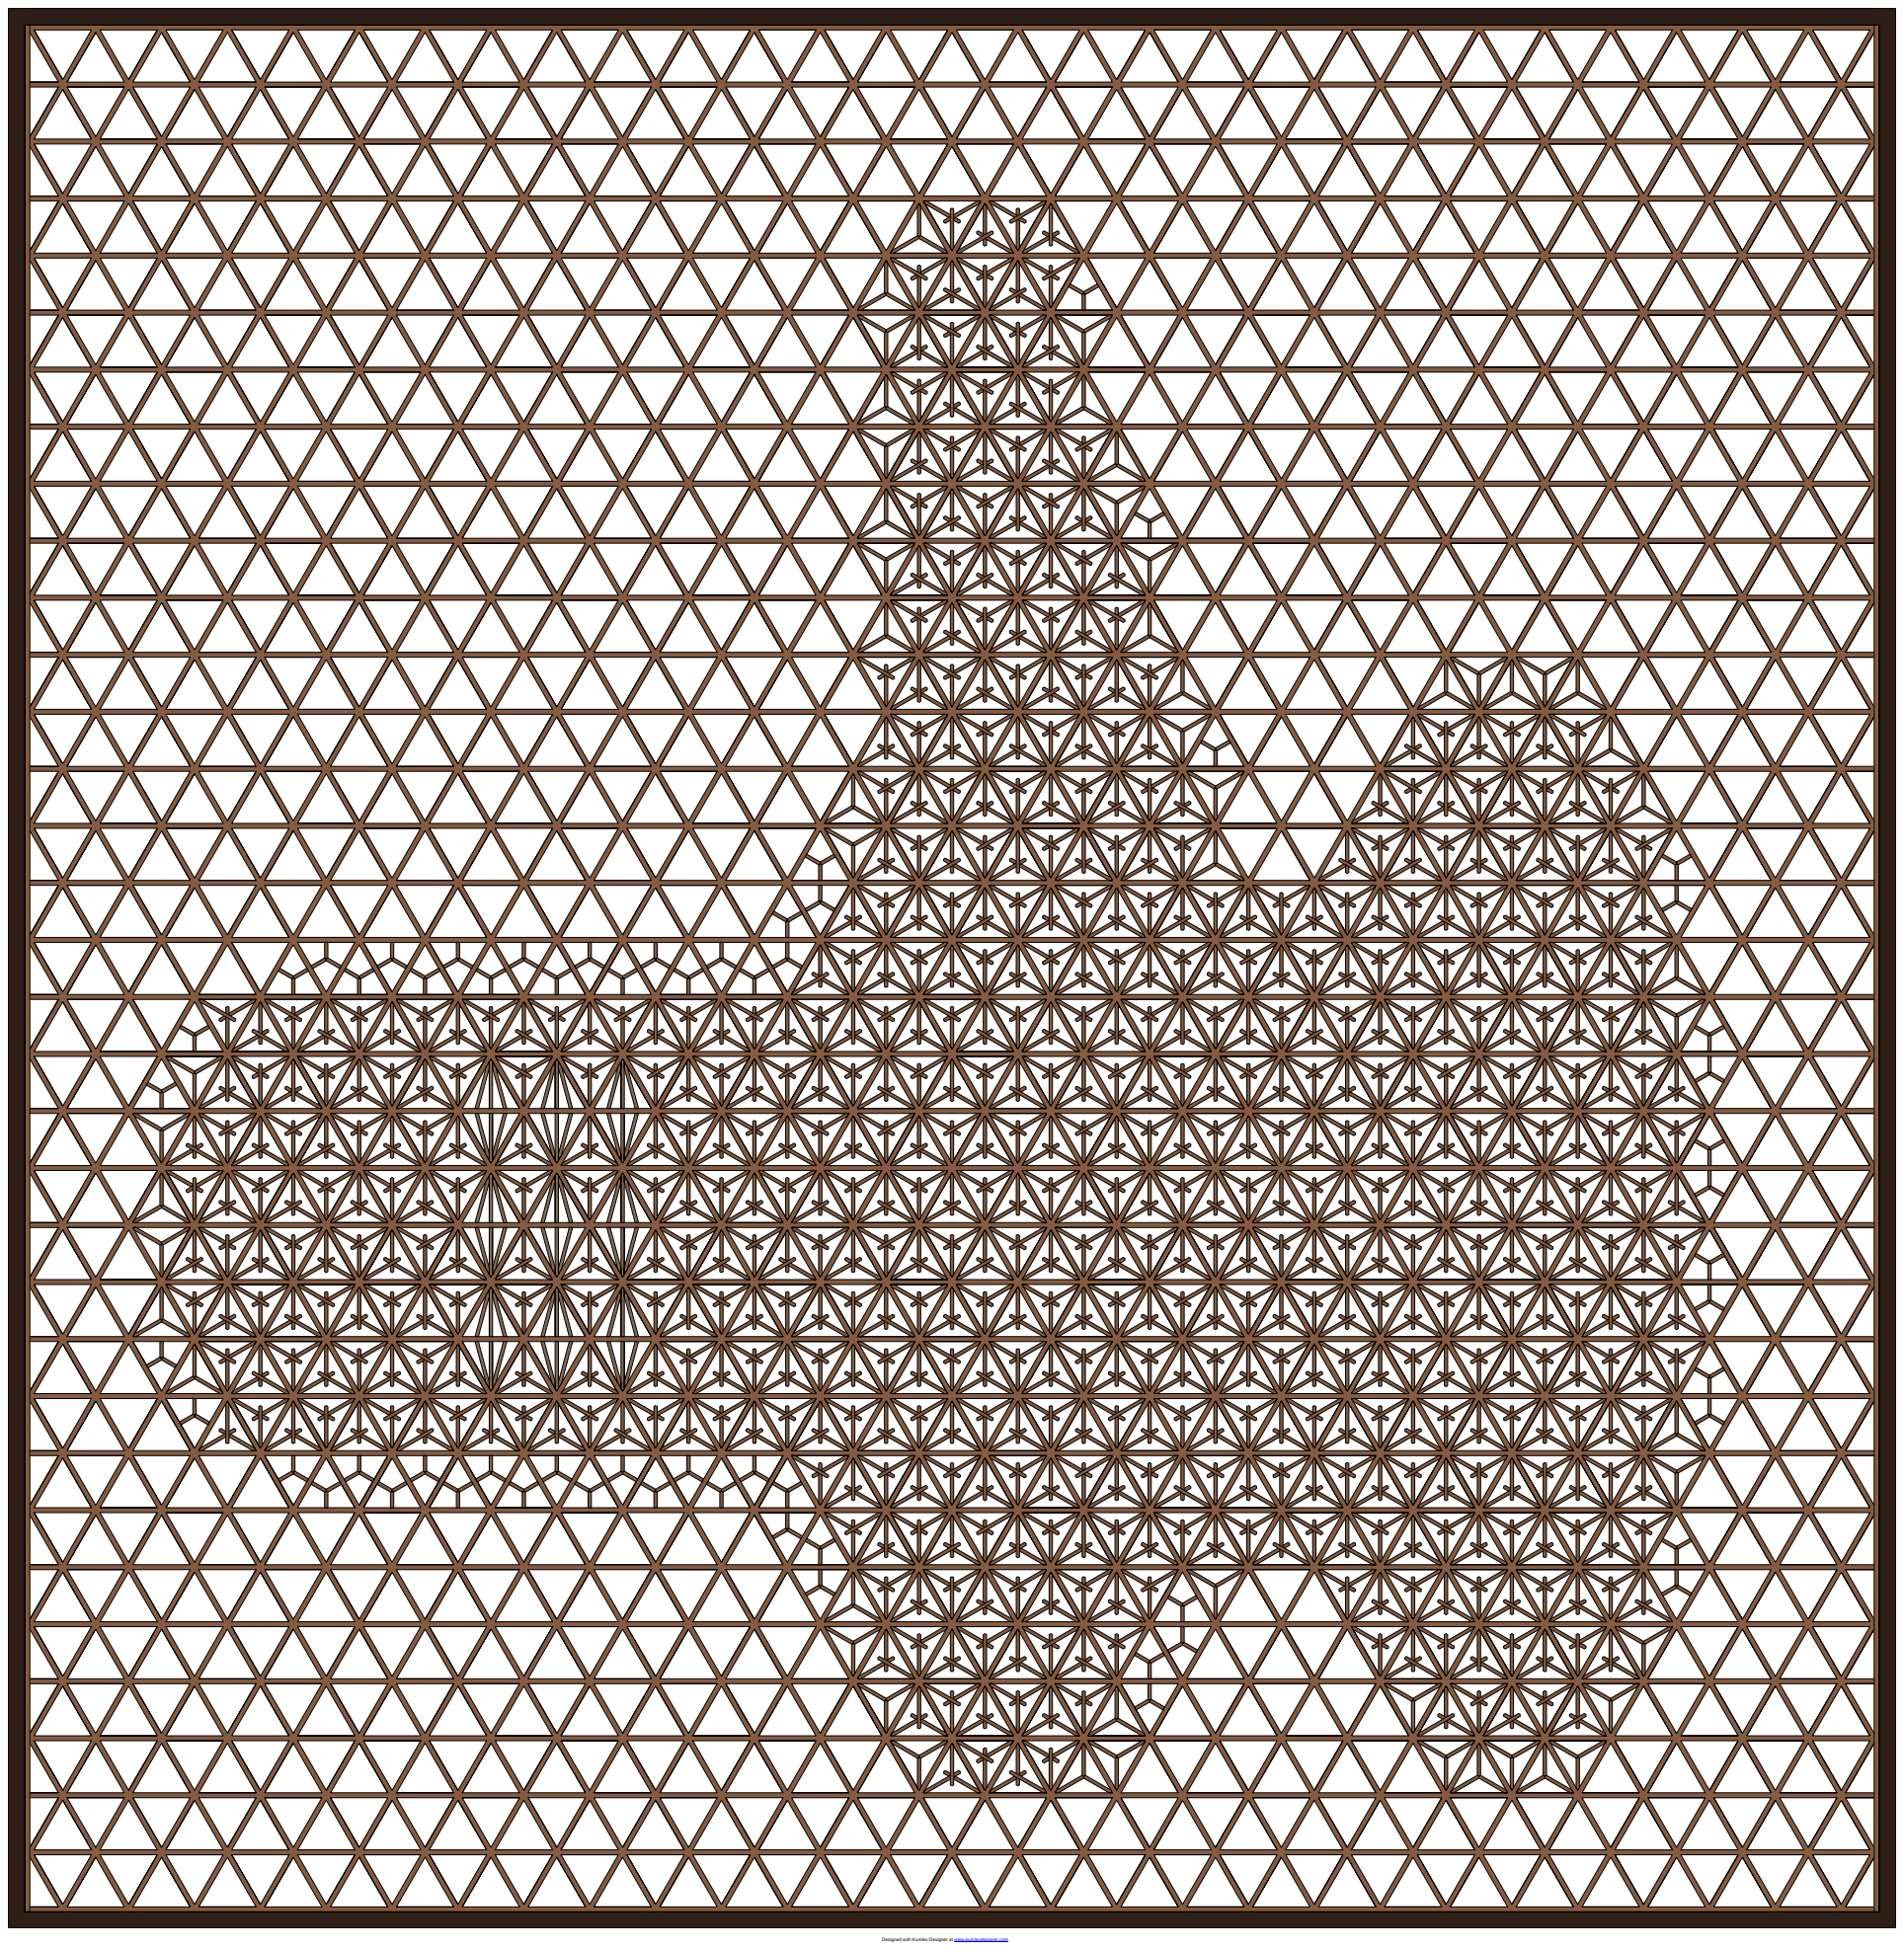
[picture p203: page 1]

Designed with Kumiko Designer at www.kumikodesigner.com

Powered by TCPDF (www.tcpdf.org)
