shivamchudasama/KumikoFrame_3DPrinting/(commit log)

2026-07-01 Add SVG insert generator script for kumikodesigner.com integration
    - Introduced a new OpenSCAD script to generate background and kumiko inserts.
    - Included detailed instructions for preparing SVG files and configuring frame dimensions.
    - Implemented modules for rendering inserts and backgrounds based on user-defined parameters.
    - Added support for both triangle and millimeter-based frame generation.
    - Ensured compatibility with processed SVG files from kumikodesigner.com.
    [Background Components.3mf, Background Components.stl, Background Inserts.3mf, Background Inserts.stl, Background Inserts__Optional.3mf, Background Inserts__Optional.stl, Fjallbo Compatible Hanger.3mf, Frame Components.3mf]
2026-07-09 Add new STL and image files for Shivling project; update modular_kumiko_panels.scad for assembly options and dimensions
    [Boarder Background.stl, Boarder.stl, Hanger.stl, Outer Frame.stl, Seams.stl, Subpanels.3mf, Subpanels.stl, modular_kumiko_panels.scad]
2026-07-17 Update parameters and add new module for insert generation
    [individual_insert_generator.scad]
2026-07-20 Enhance insert generation and modular kumiko panels
    - Updated insert pattern to start from 0 and added press fit parameter for better fit.
    - Introduced new module for pattern 40 in insert generation.
    - Enabled border background in kumiko panels and added support for multiple hanger sets.
    - Modified wall cleat module to accommodate position parameter for top and bottom sets.
    - Adjusted cleat creation logic to ensure proper alignment and engagement for dual hanger sets.
    [Boarder Background 2 Hangers.stl, Boarder Background.3mf, Boarder.3mf, Boarder_And_Boarder_Background.stl, Hanger 2 Hangers.stl, Hanger.3mf, Insert_0_4mm.stl, Insert_19_4mm.3mf]
2026-07-20 Add Costing.xlsx for Shivling project financial analysis
    [Costing.xlsx]
2026-09-21 Add Combined Mode to modular kumiko panels and insert clearance tuning
    - Added Combined Mode to modular_kumiko_panels.scad to assemble components into a single printable model
    - Added Fuse_Components, Include_Hanger, and Include_Wall_Mount parameters
    - Rescaled default frame parameters (11mm pitch, 5mm depth, 1mm thickness)
    - Added Insert_Clearance and refactored insert_triangle() in individual_insert_generator.scad
    - Added Git LFS tracking for *.stl, *.3mf, and *.pdf in .gitattributes
    [individual_insert_generator.scad, modular_kumiko_panels.scad]
